alowell-ssl/ethernet_audio/spice/pmos_switch.asc

C1: cap; 10000n
Q1: pnp; 2N3906
R1: res; 10k
R2: res; 10k
R3: res; 100
S1: sw; MYSW
V1: voltage; 12
V2: voltage; PWL(0 -1 1 -1 1.000001 1 2 1)
Named nets: 0
.tran 3
.model MYSW SW()
