alowell-ssl/ethernet_audio/kicad/tdm2ethernet1/tdm2ethernet1.kicad_pcb

## KiCad design kicad/tdm2ethernet1/tdm2ethernet1.kicad_pcb (2025-10-06)

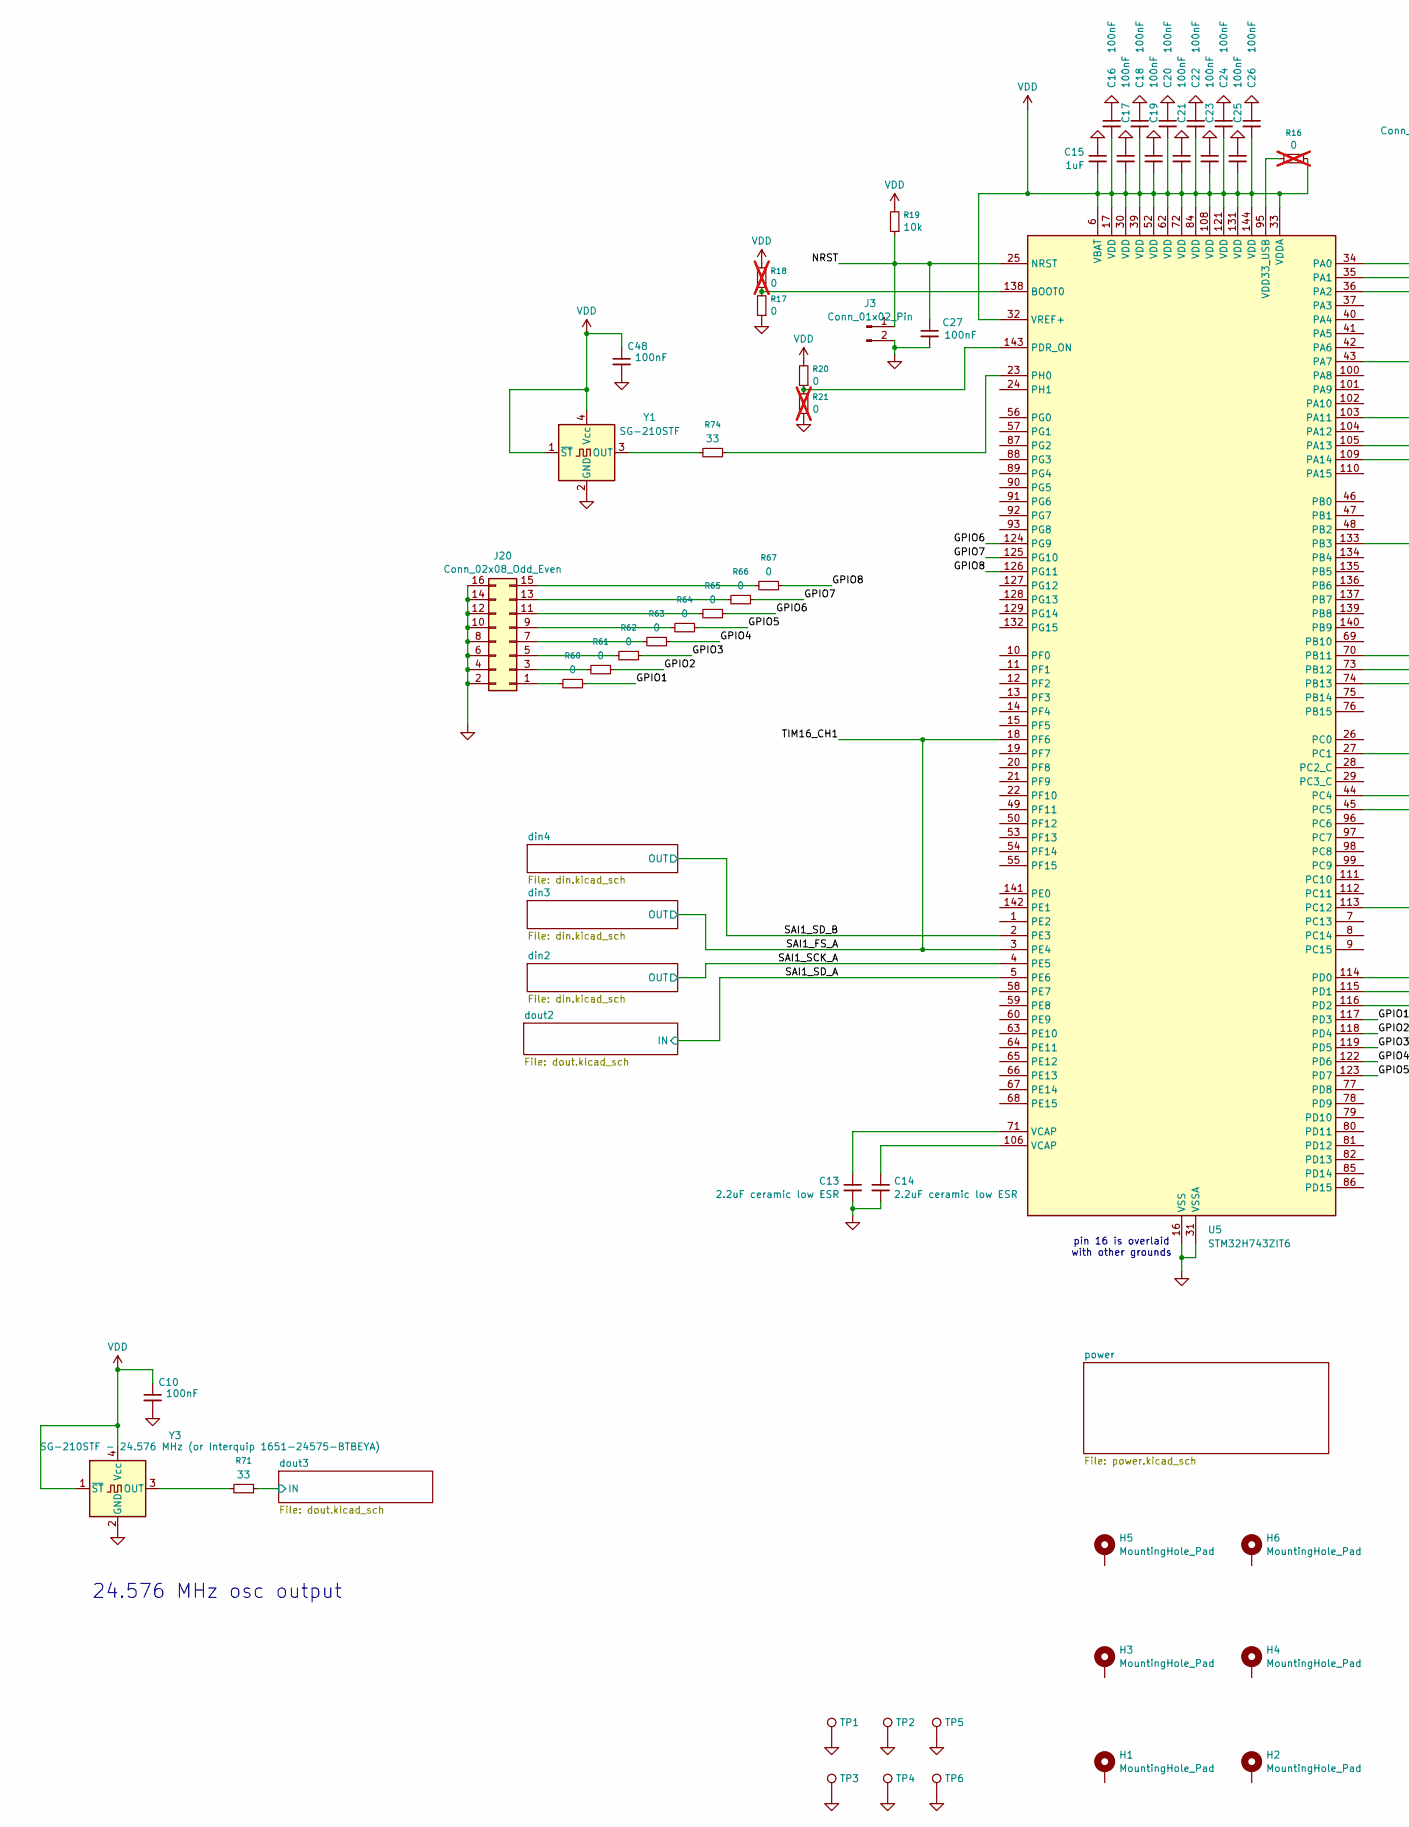
[picture p1: schematic tdm2ethernet1.kicad_sch, part in row 1, column 1]

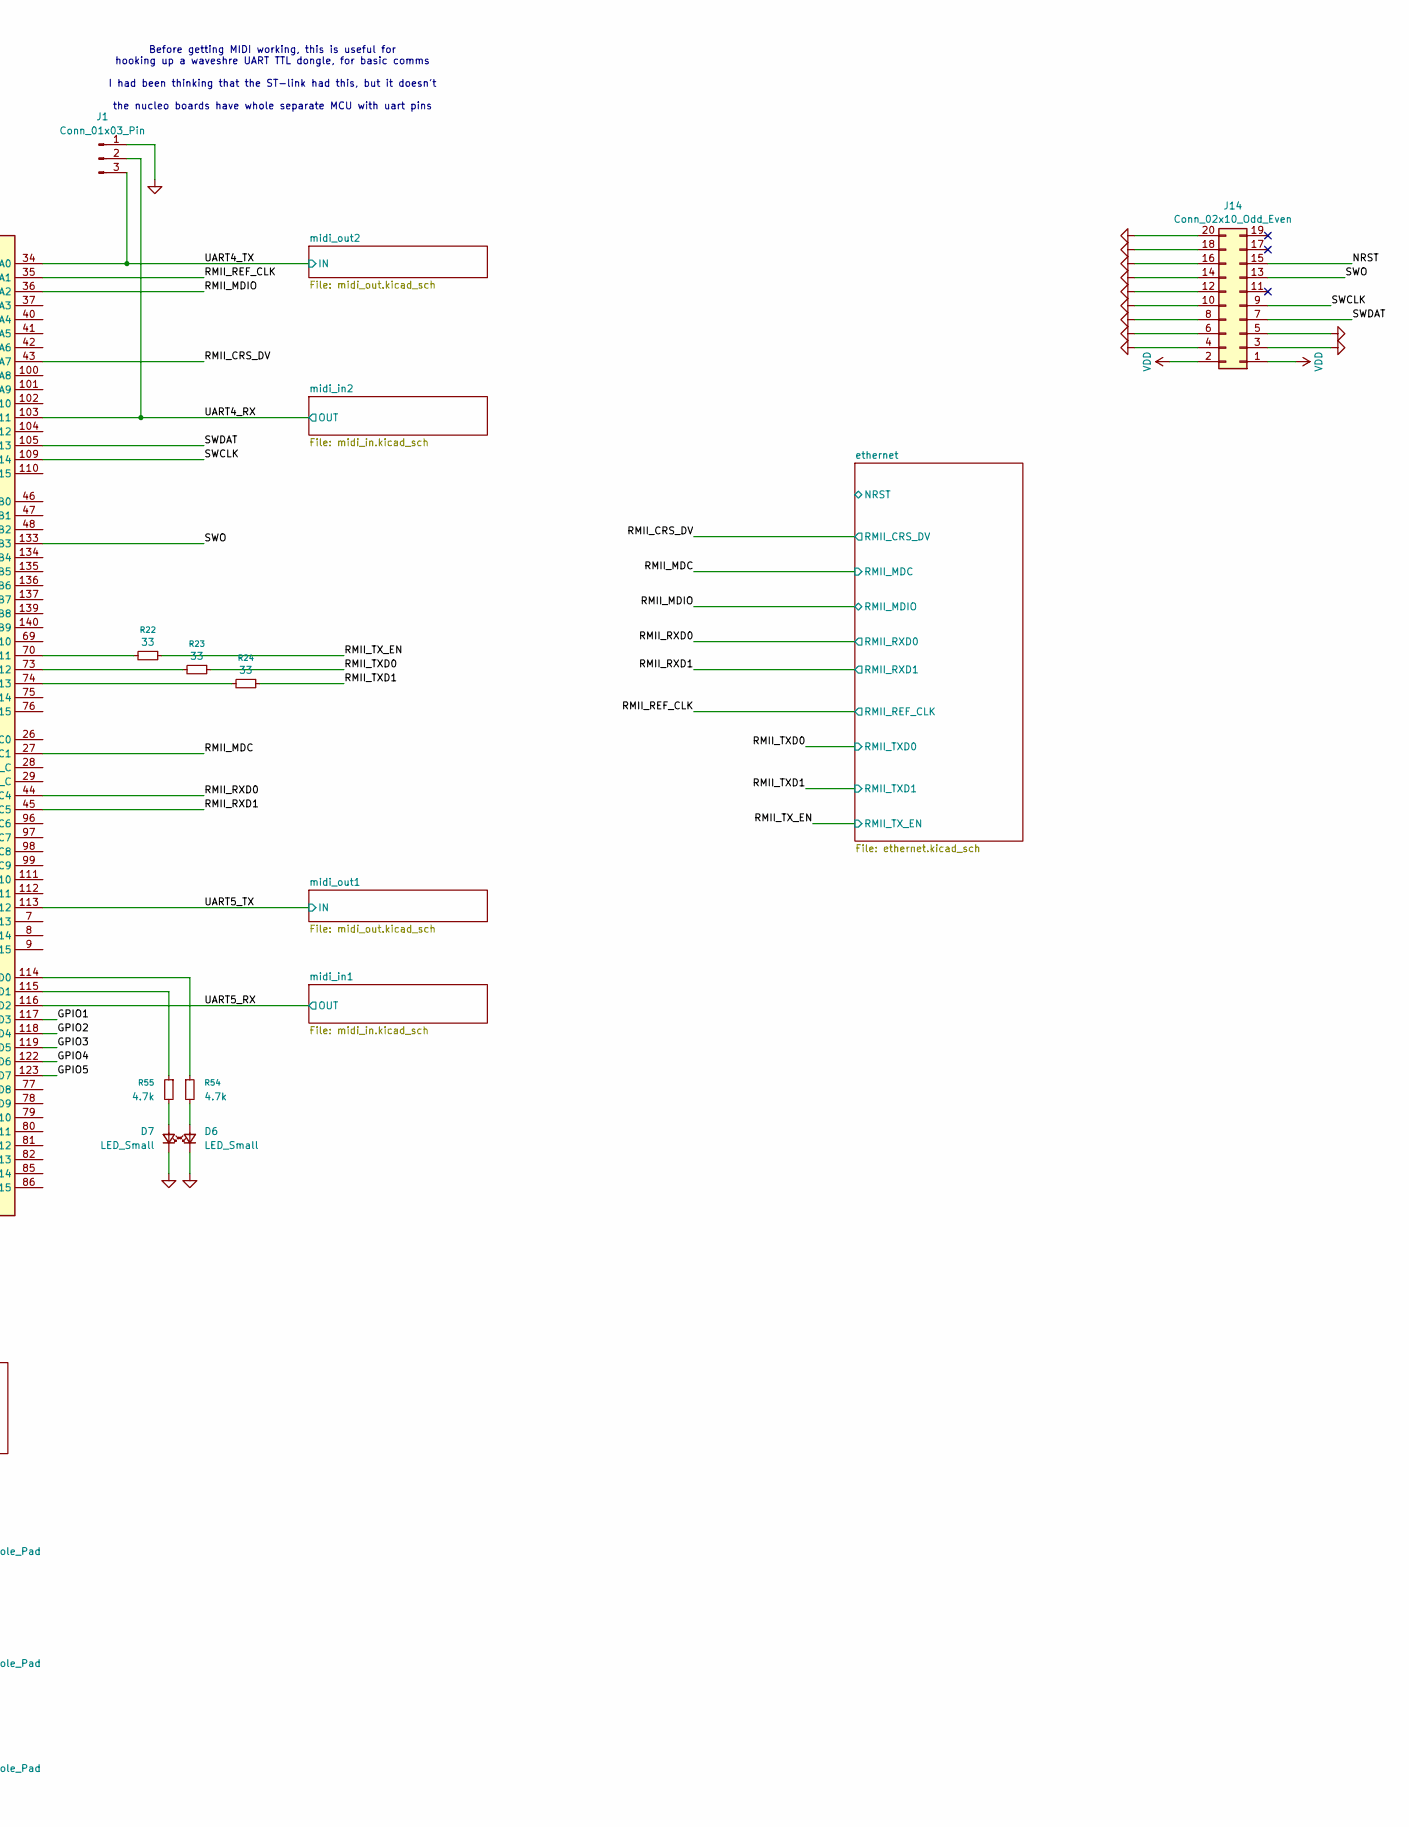
[picture p2: schematic tdm2ethernet1.kicad_sch, part in row 1, column 2]

Parts:
C10, C16, C17, C18, C19, C20, C21, C22, C23, C24, C25, C26, C27, C48: 100nF; C_0603_1608Metric; LCSC Part # C14663
C13, C14: 2.2uF ceramic low ESR; C_0603_1608Metric; LCSC Part # C23630
C15: 1uF; C_0603_1608Metric; LCSC Part # C15849
D6, D7: LED_Small; LED_0603_1608Metric; LCSC Part # C2286
H1, H2, H3, H4, H5, H6: MountingHole_Pad; MountingHole_3.2mm_M3_DIN965
J1: Conn_01x03_Pin; PinHeader_1x03_P2.54mm_Vertical
J3: Conn_01x02_Pin; PinHeader_1x02_P2.54mm_Vertical
J14: Conn_02x10_Odd_Even; PinHeader_2x10_P2.54mm_Vertical
J20: Conn_02x08_Odd_Even; PinSocket_2x08_P2.54mm_Vertical
R16, R18, R21: 0; R_0603_1608Metric; LCSC Part # C21189; not fitted
R17, R20, R60, R61, R62, R63, R64, R65, R66, R67: 0; R_0603_1608Metric; LCSC Part # C21189
R19: 10k; R_0603_1608Metric; LCSC Part # C15401
R22, R23, R24, R71, R74: 33; R_0603_1608Metric; LCSC Part # C23140
R54, R55: 4.7k; R_0603_1608Metric; LCSC Part # C23162
TP1, TP2, TP3, TP4, TP5, TP6: TestPoint; TestPoint_THTPad_D1.5mm_Drill0.7mm
U5: STM32H743ZIT6; LQFP-144_20x20mm_P0.5mm; LCSC Part # C114408
Y1: SG-210STF; Oscillator_SMD_SeikoEpson_SG210-4Pin_2.5x2.0mm; LCSC Part # C70560
Y3: SG-210STF - 24.576 MHz (or Interquip 1651-24575-B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; Oscillator_SMD_SeikoEpson_SG210-4Pin_2.5x2.0mm; LCSC Part # C3003263

Connections:
/GPIO1: R60.1, U5.117 (PD3)
/GPIO2: R61.1, U5.118 (PD4)
/GPIO3: R62.1, U5.119 (PD5)
/GPIO4: R63.1, U5.122 (PD6)
/GPIO5: R64.1, U5.123 (PD7)
/GPIO6: R65.1, U5.124 (PG9)
/GPIO7: R66.1, U5.125 (PG10)
/GPIO8: R67.1, U5.126 (PG11)
/NRST: C27.1, J3.1, J14.15, R19.1, U5.25 (NRST)
/RMII_CRS_DV: U5.43 (PA7); also elsewhere on the board
/RMII_MDC: U5.27 (PC1); also elsewhere on the board
/RMII_MDIO: U5.36 (PA2); also elsewhere on the board
/RMII_REF_CLK: U5.35 (PA1); also elsewhere on the board
/RMII_RXD0: U5.44 (PC4); also elsewhere on the board
/RMII_RXD1: U5.45 (PC5); also elsewhere on the board
/RMII_TXD0: R23.1; also elsewhere on the board
/RMII_TXD1: R24.1; also elsewhere on the board
/RMII_TX_EN: R22.1; also elsewhere on the board
/SAI1_FS_A: U5.3 (PE4), U5.18 (PF6); also elsewhere on the board
/SAI1_SCK_A: U5.4 (PE5); also elsewhere on the board
/SAI1_SD_A: U5.5 (PE6); also elsewhere on the board
/SAI1_SD_B: U5.2 (PE3); also elsewhere on the board
/SWCLK: J14.9, U5.109 (PA14)
/SWDAT: J14.7, U5.105 (PA13)
/SWO: J14.13, U5.133 (PB3)
/UART4_RX: J1.2, U5.103 (PA11); also elsewhere on the board
/UART4_TX: J1.3, U5.34 (PA0); also elsewhere on the board
/UART5_RX: U5.116 (PD2); also elsewhere on the board
/UART5_TX: U5.113 (PC12); also elsewhere on the board
/dout3/IN: R71.1; also elsewhere on the board
GND: C10.2, C13.2, C14.2, C15.1, C16.1, C17.1, C18.1, C19.1, C20.1, C21.1, C22.1, C23.1, C24.1, C25.1, C26.1, C27.2, C48.2, D6.1 (K), D7.1 (K), J1.1, J3.2, J14.3, J14.4, J14.5, J14.6, J14.8, J14.10, J14.12, J14.14, J14.16, J14.18, J14.20, J20.2, J20.4, J20.6, J20.8, J20.10, J20.12, J20.14, J20.16, R17.1, R21.1, TP1.1, TP2.1, TP3.1, TP4.1, TP5.1, TP6.1, U5.16 (VSS), U5.31 (VSSA), U5.38 (VSS), U5.51 (VSS), U5.61 (VSS), U5.83 (VSS), U5.94 (VSS), U5.107 (VSS), U5.120 (VSS), U5.130 (VSS), Y1.2 (GND), Y3.2 (GND); also elsewhere on the board
unnamed: C13.1, U5.71 (VCAP)
unnamed: C14.1, U5.106 (VCAP)
unnamed: D6.2 (A), R54.2
unnamed: D7.2 (A), R55.2
unnamed: J20.1, R60.2
unnamed: J20.3, R61.2
unnamed: J20.5, R62.2
unnamed: J20.7, R63.2
unnamed: J20.9, R64.2
unnamed: J20.11, R65.2
unnamed: J20.13, R66.2
unnamed: J20.15, R67.2
unnamed: R17.2, R18.1, U5.138 (BOOT0)
unnamed: R22.2, U5.70 (PB11)
unnamed: R23.2, U5.73 (PB12)
unnamed: R24.2, U5.74 (PB13)
unnamed: R54.1, U5.114 (PD0)
unnamed: R55.1, U5.115 (PD1)
unnamed: R20.1, R21.2, U5.143 (PDR_ON)
unnamed: R74.1, U5.23 (PH0)
unnamed: R16.1, U5.95 (VDD33_USB)
unnamed: R74.2, Y1.3 (OUT)
unnamed: R71.2, Y3.3 (OUT)
VDD: C10.1, C15.2, C16.2, C17.2, C18.2, C19.2, C20.2, C21.2, C22.2, C23.2, C24.2, C25.2, C26.2, C48.1, J14.1, J14.2, R16.2, R18.2, R19.2, R20.2, U5.6 (VBAT), U5.17 (VDD), U5.30 (VDD), U5.32 (VREF+), U5.33 (VDDA), U5.39 (VDD), U5.52 (VDD), U5.62 (VDD), U5.72 (VDD), U5.84 (VDD), U5.108 (VDD), U5.121 (VDD), U5.131 (VDD), U5.144 (VDD), Y1.1 (~ST), Y1.4 (Vcc), Y3.1 (~ST), Y3.4 (Vcc); also elsewhere on the board

Notes on the sheet:
24.576 MHz osc output
pin 16 is overlaid with other grounds
Before getting MIDI working, this is useful for hooking up a waveshre UART TTL dongle, for basic comms I had been thinking that the ST-link had this, but it doesn't the nucleo boards have whole separate MCU with uart pins

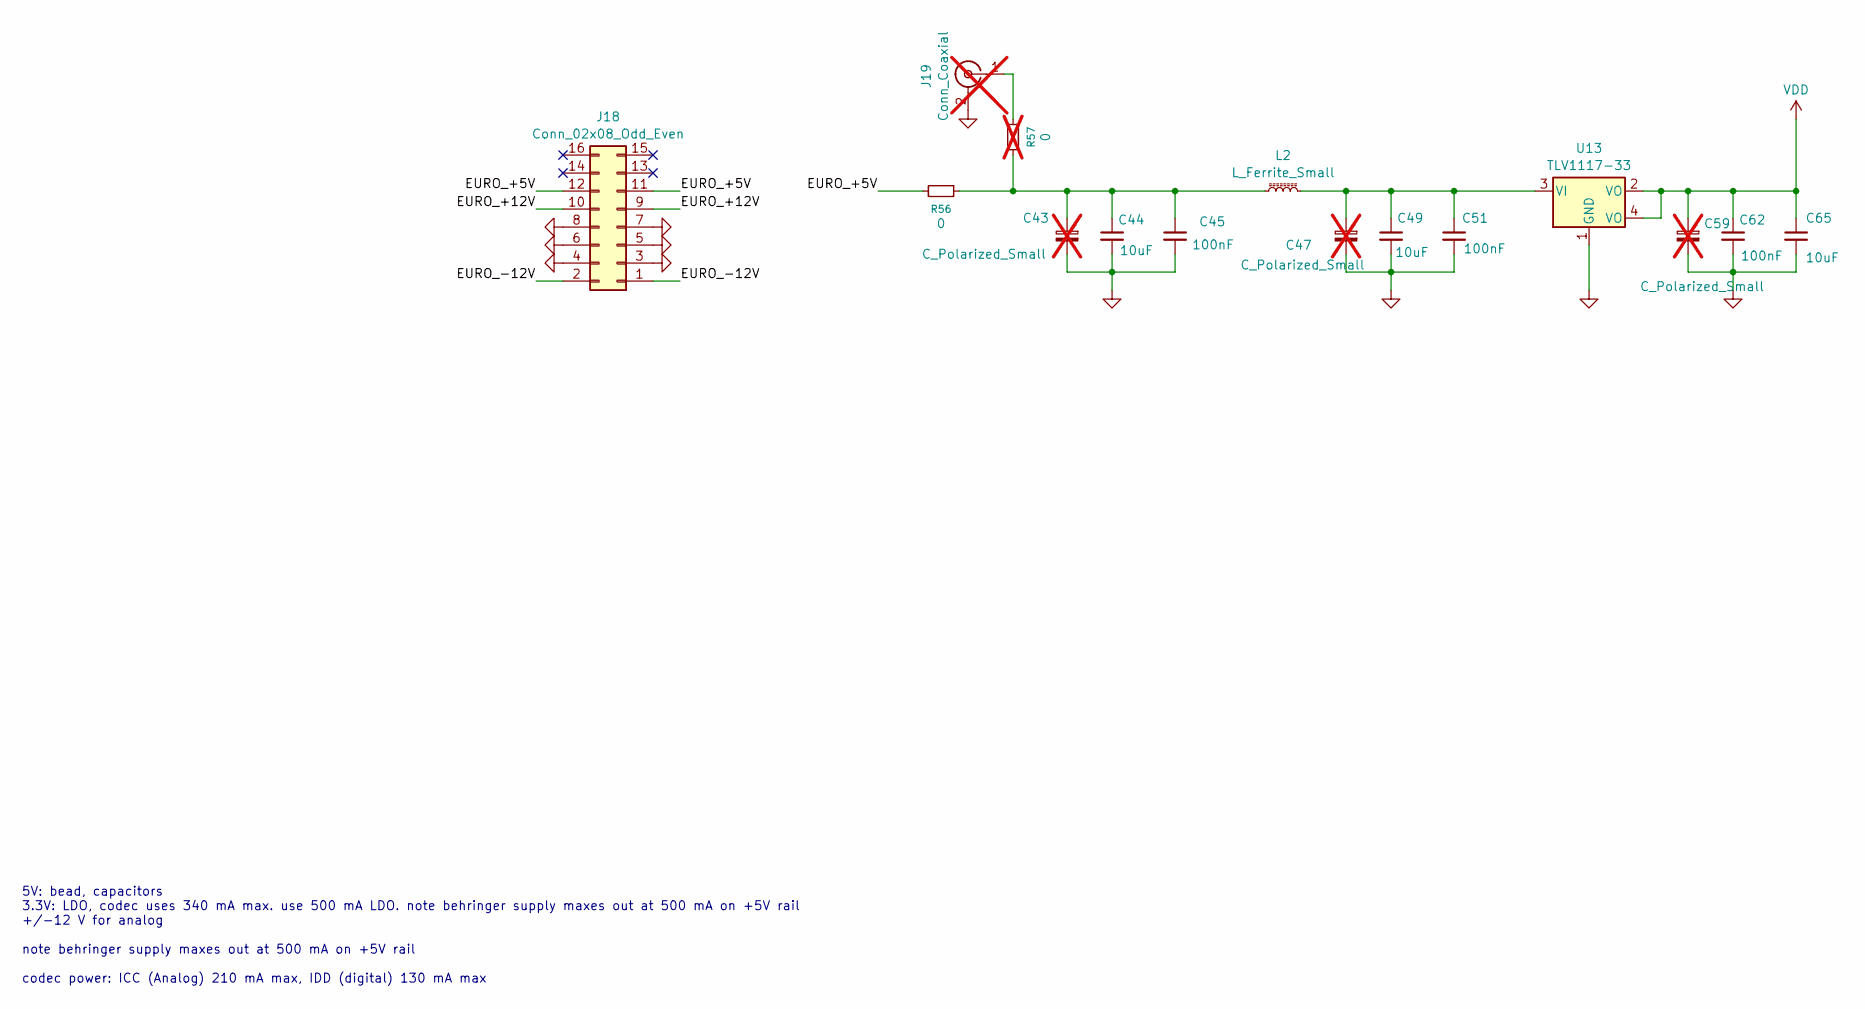
[picture p3: schematic power.kicad_sch]

Parts:
C43, C47, C59: C_Polarized_Small; CP_Radial_D8.0mm_P3.50mm; not fitted
C44, C49, C65: 10uF; C_0603_1608Metric; LCSC Part # C96446
C45, C51, C62: 100nF; C_0603_1608Metric; LCSC Part # C14663
J18: Conn_02x08_Odd_Even; PinSocket_2x08_P2.54mm_Vertical
J19: Conn_Coaxial; SMA_Amphenol_901-144_Vertical; not fitted
L2: L_Ferrite_Small; L_0603_1608Metric; LCSC Part # C1002
R56: 0; R_0603_1608Metric; LCSC Part # C21189
R57: 0; R_0603_1608Metric; LCSC Part # C21189; not fitted
U13: TLV1117-33; SOT-223

Connections:
/power/EURO_+5V: J18.11, J18.12, R56.1
/power/EURO_+12V: J18.9, J18.10
/power/EURO_-12V: J18.1, J18.2
GND: C43.2, C44.2, C45.2, C47.2, C49.2, C51.2, C59.2, C62.2, C65.2, J18.3, J18.4, J18.5, J18.6, J18.7, J18.8, J19.2 (Ext), U13.1 (GND); also elsewhere on the board
unnamed: C43.1, C44.1, C45.1, L2.1, R56.2, R57.1
unnamed: J19.1 (In), R57.2
unnamed: C47.1, C49.1, C51.1, L2.2, U13.3 (VI)
VDD: C59.1, C62.1, C65.1, U13.2 (VO), U13.4 (VO); also elsewhere on the board

Notes on the sheet:
5V: bead, capacitors 3.3V: LDO, codec uses 340 mA max. use 500 mA LDO. note behringer supply maxes out at 500 mA on +5V rail +/-12 V for analog note behringer supply maxes out at 500 mA on +5V rail codec power: ICC (Analog) 210 mA max, IDD (digital) 130 mA max

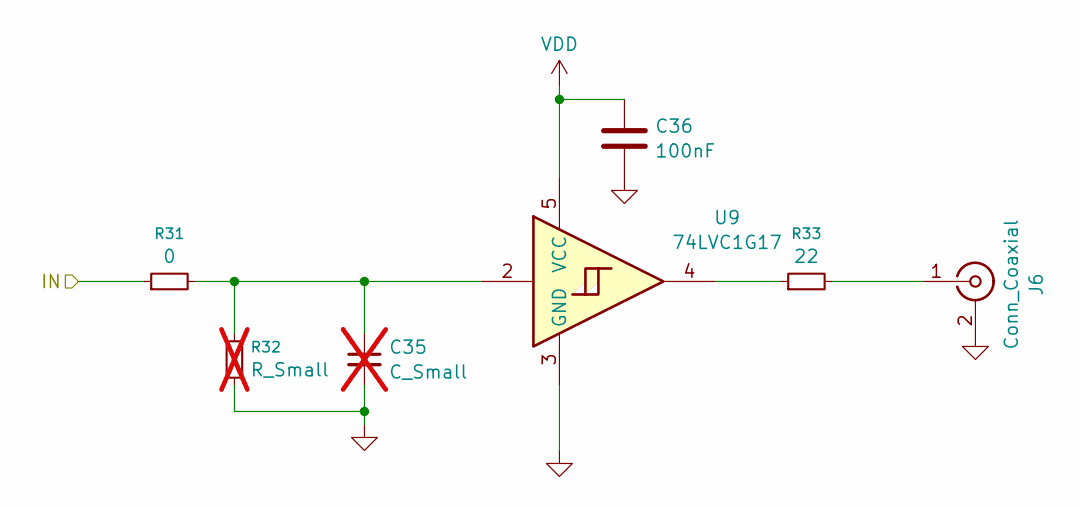
[picture p4: schematic dout.kicad_sch]

Parts:
C35: C_Small; C_0603_1608Metric; not fitted
C36: 100nF; C_0603_1608Metric; LCSC Part # C14663
J6: Conn_Coaxial; SMA_Amphenol_901-144_Vertical
R31: 0; R_0603_1608Metric; LCSC Part # C21189
R32: R_Small; R_0603_1608Metric; not fitted
R33: 22; R_0603_1608Metric; LCSC Part # C23345
U9: 74LVC1G17; SOT-23-5; LCSC Part # C7836

Connections:
/SAI1_SD_A: R31.1; also elsewhere on the board
GND: C35.2, C36.2, J6.2 (Ext), R32.1, U9.3 (GND); also elsewhere on the board
unnamed: C35.1, R31.2, R32.2, U9.2
unnamed: J6.1 (In), R33.2
unnamed: R33.1, U9.4
VDD: C36.1, U9.5 (VCC); also elsewhere on the board

Parts of its further copies:
C12: C_Small; C_0603_1608Metric; not fitted
C52: 100nF; C_0603_1608Metric; LCSC Part # C14663
J2: Conn_Coaxial; SMA_Amphenol_901-144_Vertical
R72: 0; R_0603_1608Metric; LCSC Part # C21189
R73: R_Small; R_0603_1608Metric; not fitted
R76: 22; R_0603_1608Metric; LCSC Part # C23345
U14: 74LVC1G17; SOT-23-5; LCSC Part # C7836

Connections of its further copies:
/dout3/IN: R72.1; also elsewhere on the board
GND: C12.2, C52.2, J2.2 (Ext), R73.1, U14.3 (GND); also elsewhere on the board
unnamed: C12.1, R72.2, R73.2, U14.2
unnamed: J2.1 (In), R76.2
unnamed: R76.1, U14.4
VDD: C52.1, U14.5 (VCC); also elsewhere on the board

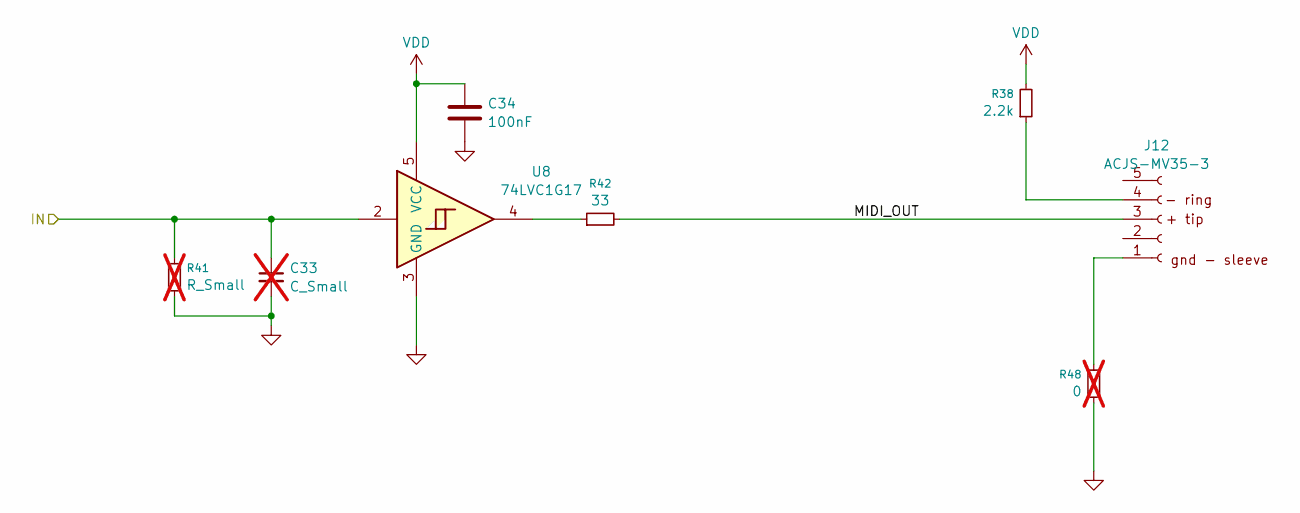
[picture p5: schematic midi_out.kicad_sch]

Parts:
C33: C_Small; C_0603_1608Metric; not fitted
C34: 100nF; C_0603_1608Metric; LCSC Part # C14663
J12: ACJS-MV35-3; Amphenol_ACJS
R38: 2.2k; R_0603_1608Metric; LCSC Part # C4190
R41: R_Small; R_0603_1608Metric; not fitted
R42: 33; R_0603_1608Metric; LCSC Part # C23140
R48: 0; R_0603_1608Metric; LCSC Part # C21189; not fitted
U8: 74LVC1G17; SOT-23-5; LCSC Part # C7836

Connections:
/UART5_TX: C33.1, R41.2, U8.2; also elsewhere on the board
/midi_out1/MIDI_OUT: J12.3, R42.2
GND: C33.2, C34.2, R41.1, R48.1, U8.3 (GND); also elsewhere on the board
unnamed: J12.1, R48.2
unnamed: J12.4, R38.1
unnamed: R42.1, U8.4
VDD: C34.1, R38.2, U8.5 (VCC); also elsewhere on the board

Parts of its further copies:
C29: C_Small; C_0603_1608Metric; not fitted
C30: 100nF; C_0603_1608Metric; LCSC Part # C14663
J13: ACJS-MV35-3; Amphenol_ACJS
R28: R_Small; R_0603_1608Metric; not fitted
R29: 33; R_0603_1608Metric; LCSC Part # C23140
R30: 2.2k; R_0603_1608Metric; LCSC Part # C4190
R49: 0; R_0603_1608Metric; LCSC Part # C21189; not fitted
U6: 74LVC1G17; SOT-23-5; LCSC Part # C7836

Connections of its further copies:
/UART4_TX: C29.1, R28.2, U6.2; also elsewhere on the board
/midi_out2/MIDI_OUT: J13.3, R29.2
GND: C29.2, C30.2, R28.1, R49.1, U6.3 (GND); also elsewhere on the board
unnamed: J13.1, R49.2
unnamed: J13.4, R30.1
unnamed: R29.1, U6.4
VDD: C30.1, R30.2, U6.5 (VCC); also elsewhere on the board

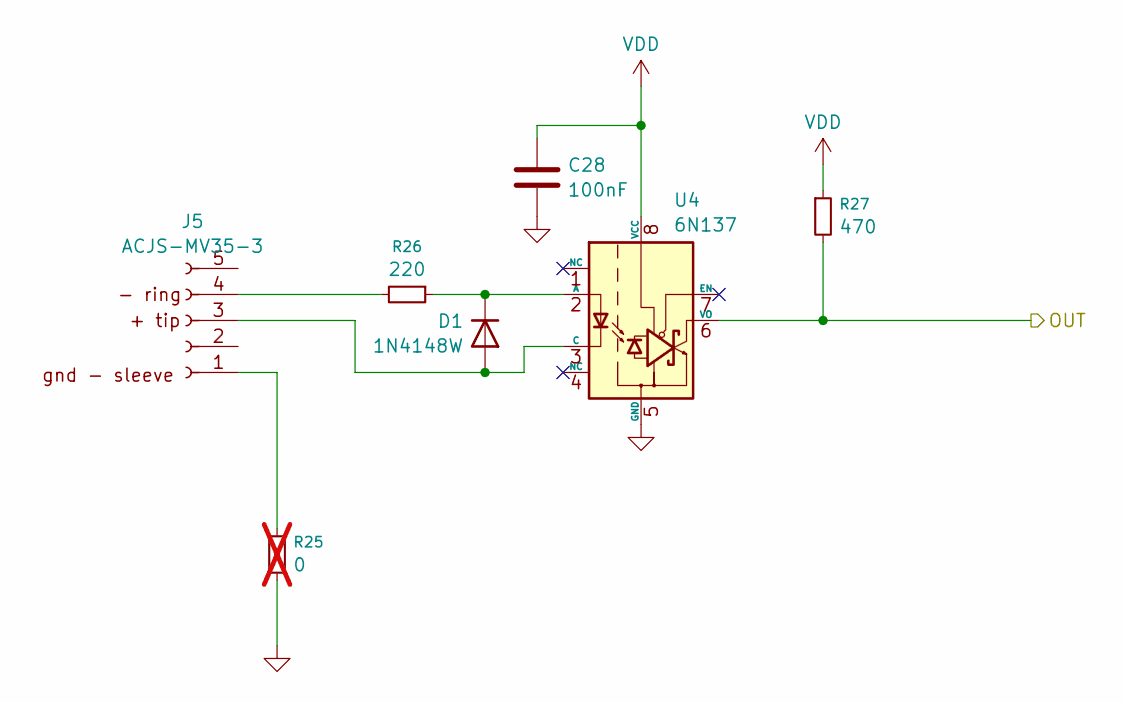
[picture p6: schematic midi_in.kicad_sch]

Parts:
C28: 100nF; C_0603_1608Metric; LCSC Part # C14663
D1: 1N4148W; D_SOD-123; LCSC Part # C81598
J5: ACJS-MV35-3; Amphenol_ACJS
R25: 0; R_0603_1608Metric; LCSC Part # C21189; not fitted
R26: 220; R_0603_1608Metric; LCSC Part # C22962
R27: 470; R_0603_1608Metric; LCSC Part # C23179
U4: 6N137; DIP-8_W7.62mm

Connections:
/UART4_RX: R27.2, U4.6 (VO); also elsewhere on the board
GND: C28.2, R25.1, U4.5 (GND); also elsewhere on the board
unnamed: D1.2 (A), J5.3, U4.3 (C)
unnamed: D1.1 (K), R26.1, U4.2 (A)
unnamed: J5.1, R25.2
unnamed: J5.4, R26.2
VDD: C28.1, R27.1, U4.8 (VCC); also elsewhere on the board

Parts of its further copies:
C32: 100nF; C_0603_1608Metric; LCSC Part # C14663
D5: 1N4148W; D_SOD-123; LCSC Part # C81598
J10: ACJS-MV35-3; Amphenol_ACJS
R44: 220; R_0603_1608Metric; LCSC Part # C22962
R45: 470; R_0603_1608Metric; LCSC Part # C23179
R50: 0; R_0603_1608Metric; LCSC Part # C21189; not fitted
U7: 6N137; DIP-8_W7.62mm

Connections of its further copies:
/UART5_RX: R45.2, U7.6 (VO); also elsewhere on the board
GND: C32.2, R50.1, U7.5 (GND); also elsewhere on the board
unnamed: D5.2 (A), J10.3, U7.3 (C)
unnamed: D5.1 (K), R44.1, U7.2 (A)
unnamed: J10.1, R50.2
unnamed: J10.4, R44.2
VDD: C32.1, R45.1, U7.8 (VCC); also elsewhere on the board

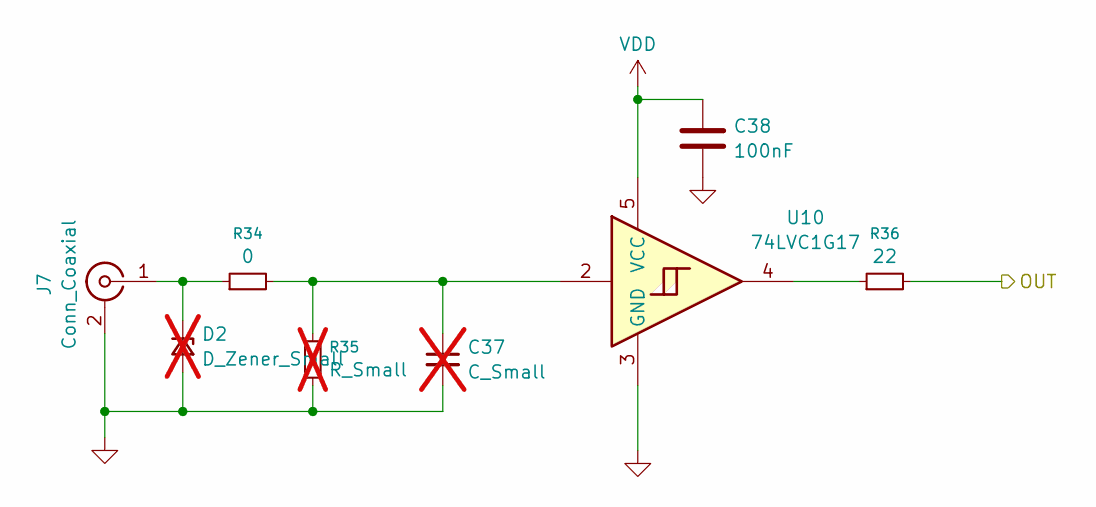
[picture p7: schematic din.kicad_sch]

Parts:
C37: C_Small; C_0603_1608Metric; not fitted
C38: 100nF; C_0603_1608Metric; LCSC Part # C14663
D2: D_Zener_Small; D_SOD-123F; not fitted
J7: Conn_Coaxial; SMA_Amphenol_901-144_Vertical
R34: 0; R_0603_1608Metric; LCSC Part # C21189
R35: R_Small; R_0603_1608Metric; not fitted
R36: 22; R_0603_1608Metric; LCSC Part # C23345
U10: 74LVC1G17; SOT-23-5; LCSC Part # C7836

Connections:
/SAI1_SCK_A: R36.2; also elsewhere on the board
GND: C37.2, C38.2, D2.2 (A), J7.2 (Ext), R35.1, U10.3 (GND); also elsewhere on the board
unnamed: C37.1, R34.2, R35.2, U10.2
unnamed: D2.1 (K), J7.1 (In), R34.1
unnamed: R36.1, U10.4
VDD: C38.1, U10.5 (VCC); also elsewhere on the board

Parts of its further copies:
C39, C41: C_Small; C_0603_1608Metric; not fitted
C40, C42: 100nF; C_0603_1608Metric; LCSC Part # C14663
D3, D4: D_Zener_Small; D_SOD-123F; not fitted
J8, J11: Conn_Coaxial; SMA_Amphenol_901-144_Vertical
R37, R43: 0; R_0603_1608Metric; LCSC Part # C21189
R39, R46: R_Small; R_0603_1608Metric; not fitted
R40, R47: 22; R_0603_1608Metric; LCSC Part # C23345
U11, U12: 74LVC1G17; SOT-23-5; LCSC Part # C7836

Connections of its further copies:
/SAI1_FS_A: R40.2; also elsewhere on the board
/SAI1_SD_B: R47.2; also elsewhere on the board
GND: C39.2, C40.2, C41.2, C42.2, D3.2 (A), D4.2 (A), J8.2 (Ext), J11.2 (Ext), R39.1, R46.1, U11.3 (GND), U12.3 (GND); also elsewhere on the board
unnamed: C39.1, R37.2, R39.2, U11.2
unnamed: C41.1, R43.2, R46.2, U12.2
unnamed: D3.1 (K), J8.1 (In), R37.1
unnamed: D4.1 (K), J11.1 (In), R43.1
unnamed: R40.1, U11.4
unnamed: R47.1, U12.4
VDD: C40.1, C42.1, U11.5 (VCC), U12.5 (VCC); also elsewhere on the board

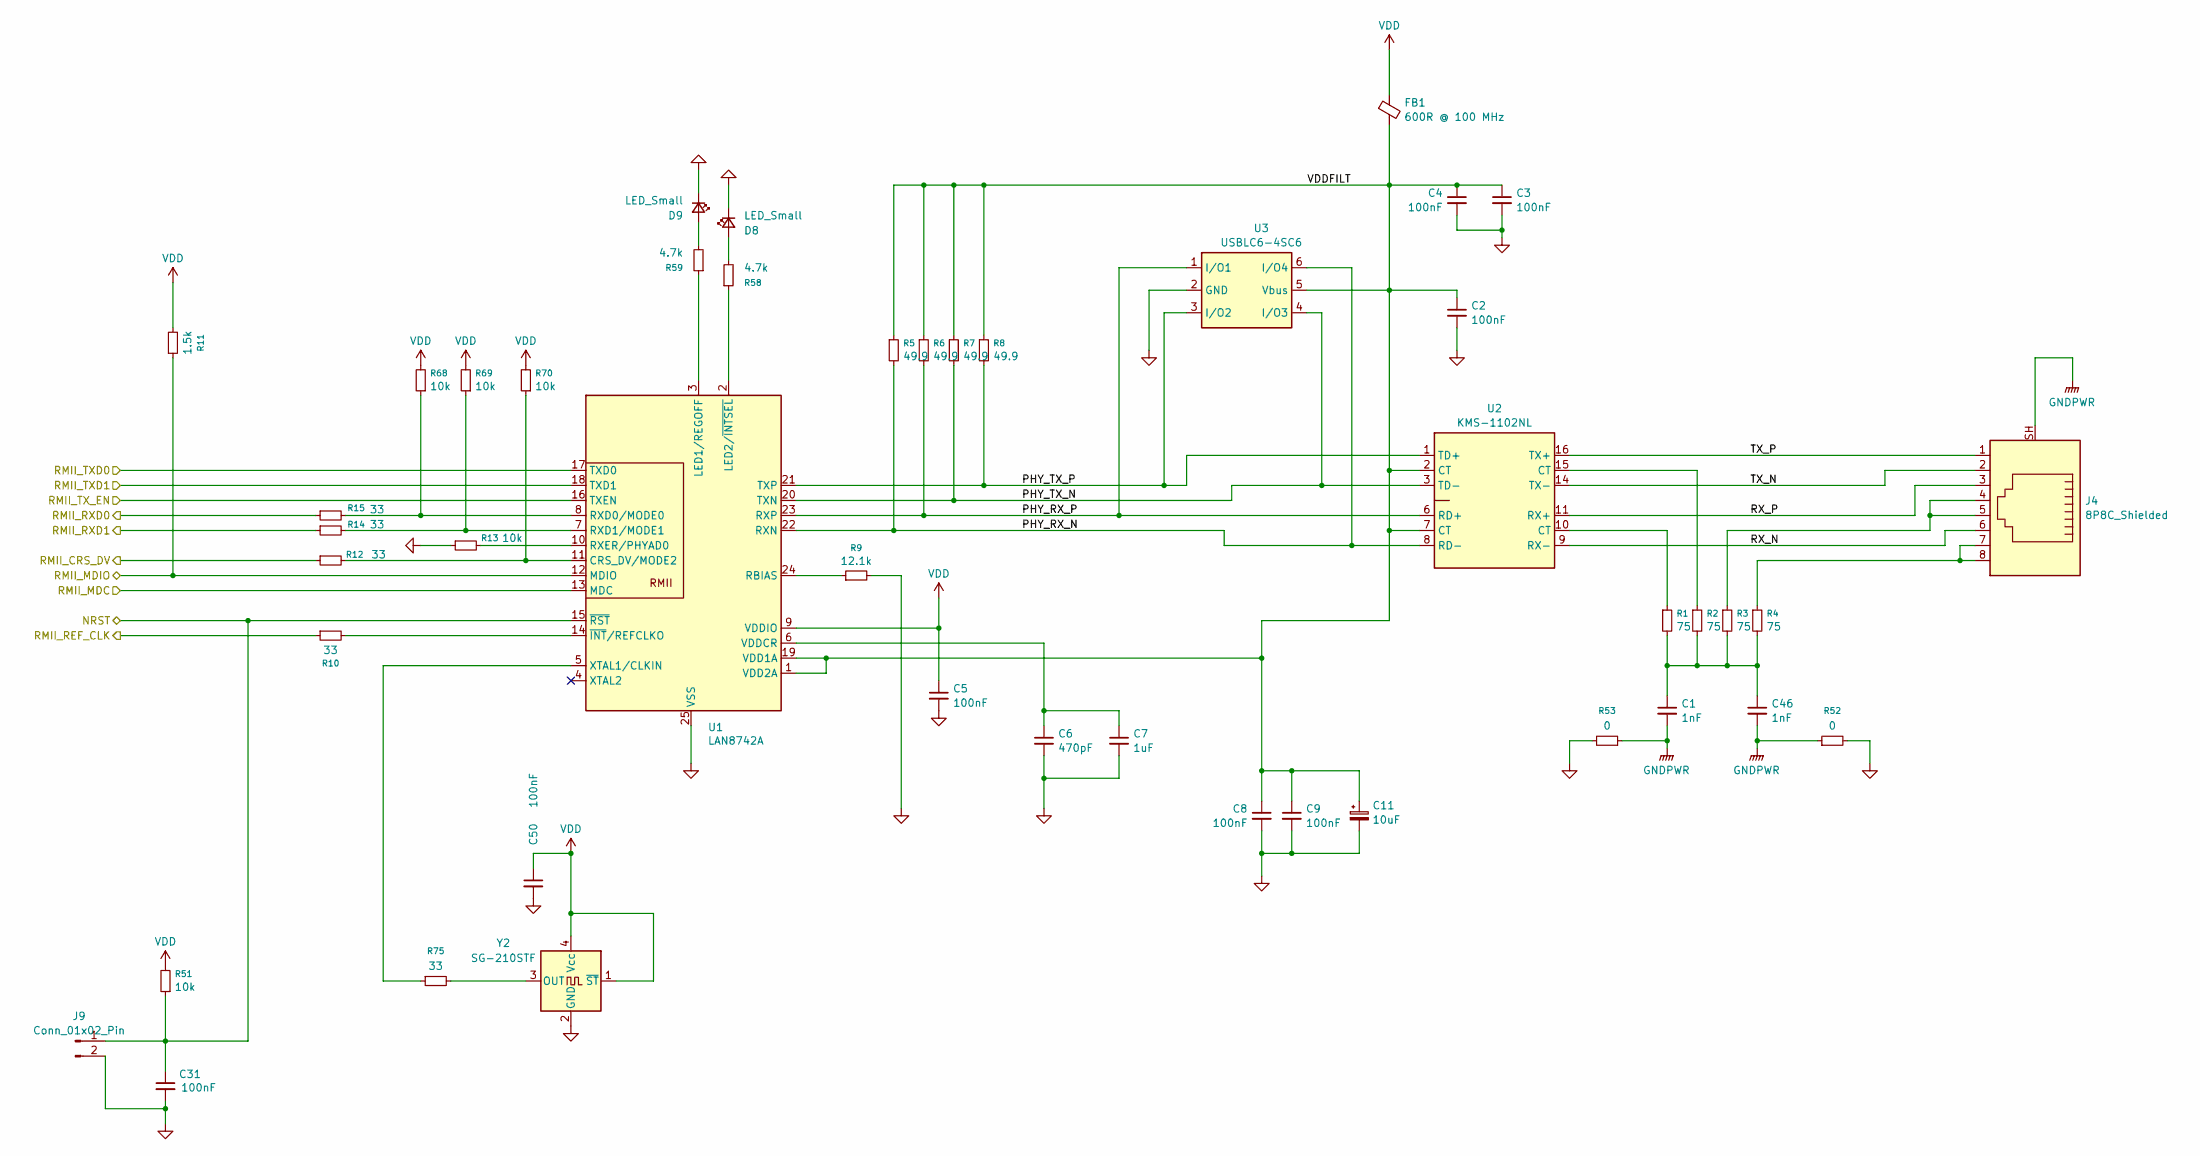
[picture p8: schematic ethernet.kicad_sch]

Parts:
C1, C46: 1nF; C_0603_1608Metric; LCSC Part # C1588
C2, C3, C4, C5, C8, C9, C31, C50: 100nF; C_0603_1608Metric; LCSC Part # C14663
C6: 470pF; C_0603_1608Metric; LCSC Part # C1620
C7: 1uF; C_0603_1608Metric; LCSC Part # C15849
C11: 10uF; C_1206_3216Metric; LCSC Part # C13585
D8, D9: LED_Small; LED_0603_1608Metric; LCSC Part # C2286
FB1: 600R @ 100 MHz; L_0603_1608Metric; LCSC Part # C1002
J4: 8P8C_Shielded; A-2014-2S-4-N-R
J9: Conn_01x02_Pin; PinHeader_1x02_P2.54mm_Vertical
R1, R2, R3, R4: 75; R_0603_1608Metric; LCSC Part # C4275
R5, R6, R7, R8: 49.9; R_0603_1608Metric; LCSC Part # C23185
R9: 12.1k; R_0603_1608Metric
R10, R12, R14, R15, R75: 33; R_0603_1608Metric; LCSC Part # C23140
R11: 1.5k; R_0603_1608Metric; LCSC Part # C22843
R13, R51, R68, R69, R70: 10k; R_0603_1608Metric; LCSC Part # C15401
R52, R53: 0; R_0603_1608Metric; LCSC Part # C21189
R58, R59: 4.7k; R_0603_1608Metric; LCSC Part # C23162
U1: LAN8742A; VQFN-24-1EP_4x4mm_P0.5mm_EP2.5x2.5mm_ThermalVias; LCSC Part # C621424
U2: KMS-1102NL; Untitled
U3: USBLC6-4SC6; SOT-23-6
Y2: SG-210STF; Oscillator_SMD_SeikoEpson_SG210-4Pin_2.5x2.0mm; LCSC Part # C70560

Connections:
/RMII_CRS_DV: R12.1; also elsewhere on the board
/RMII_MDC: U1.13 (MDC); also elsewhere on the board
/RMII_MDIO: R11.1, U1.12 (MDIO); also elsewhere on the board
/RMII_REF_CLK: R10.1; also elsewhere on the board
/RMII_RXD0: R15.1; also elsewhere on the board
/RMII_RXD1: R14.1; also elsewhere on the board
/RMII_TXD0: U1.17 (TXD0); also elsewhere on the board
/RMII_TXD1: U1.18 (TXD1); also elsewhere on the board
/RMII_TX_EN: U1.16 (TXEN); also elsewhere on the board
/ethernet/NRST: C31.1, J9.1, R51.1, U1.15 (~RST)
/ethernet/PHY_RX_N: R5.2, U1.22 (RXN), U2.8 (RD-), U3.6 (I/O4)
/ethernet/PHY_RX_P: R6.2, U1.23 (RXP), U2.6 (RD+), U3.1 (I/O1)
/ethernet/PHY_TX_N: R7.2, U1.20 (TXN), U2.3 (TD-), U3.4 (I/O3)
/ethernet/PHY_TX_P: R8.2, U1.21 (TXP), U2.1 (TD+), U3.3 (I/O2)
/ethernet/RX_N: J4.6, U2.9 (RX-)
/ethernet/RX_P: J4.3, U2.11 (RX+)
/ethernet/TX_N: J4.2, U2.14 (TX-)
/ethernet/TX_P: J4.1, U2.16 (TX+)
/ethernet/VDDFILT: C2.1, C3.1, C4.1, C8.1, C9.1, C11.1, FB1.2, R5.1, R6.1, R7.1, R8.1, U1.1 (VDD2A), U1.19 (VDD1A), U2.2 (CT), U2.7 (CT), U3.5 (Vbus)
GND: C2.2, C3.2, C4.2, C5.2, C6.2, C7.2, C8.2, C9.2, C11.2, C31.2, C50.2, D8.1 (K), D9.1 (K), J9.2, R9.2, R13.1, R52.2, R53.2, U1.25 (VSS), U3.2 (GND), Y2.2 (GND); also elsewhere on the board
GNDPWR: C1.2, C46.2, J4.SH, R52.1, R53.1
unnamed: C1.1, C46.1, R1.2, R2.2, R3.2, R4.2
unnamed: D8.2 (A), R58.2
unnamed: D9.2 (A), R59.2
unnamed: J4.4, J4.5, R3.1
unnamed: J4.7, J4.8, R4.1
unnamed: R1.1, U2.10 (CT)
unnamed: R2.1, U2.15 (CT)
unnamed: R12.2, R70.1, U1.11 (CRS_DV/MODE2)
unnamed: R59.1, U1.3 (LED1/REGOFF)
unnamed: R58.1, U1.2 (LED2/~INTSEL)
unnamed: R9.1, U1.24 (RBIAS)
unnamed: R15.2, R68.1, U1.8 (RXD0/MODE0)
unnamed: R14.2, R69.1, U1.7 (RXD1/MODE1)
unnamed: R13.2, U1.10 (RXER/PHYAD0)
unnamed: C6.1, C7.1, U1.6 (VDDCR)
unnamed: R75.1, U1.5 (XTAL1/CLKIN)
unnamed: R10.2, U1.14 (~INT/REFCLKO)
unnamed: R75.2, Y2.3 (OUT)
VDD: C5.1, C50.1, FB1.1, R11.2, R51.2, R68.2, R69.2, R70.2, U1.9 (VDDIO), Y2.1 (~ST), Y2.4 (Vcc); also elsewhere on the board
