alowell-ssl/ethernet_audio/kicad/tdm2ethernet1/tdm2ethernet1.kicad_pcb

## KiCad design kicad/tdm2ethernet1/tdm2ethernet1.kicad_pcb (continued)

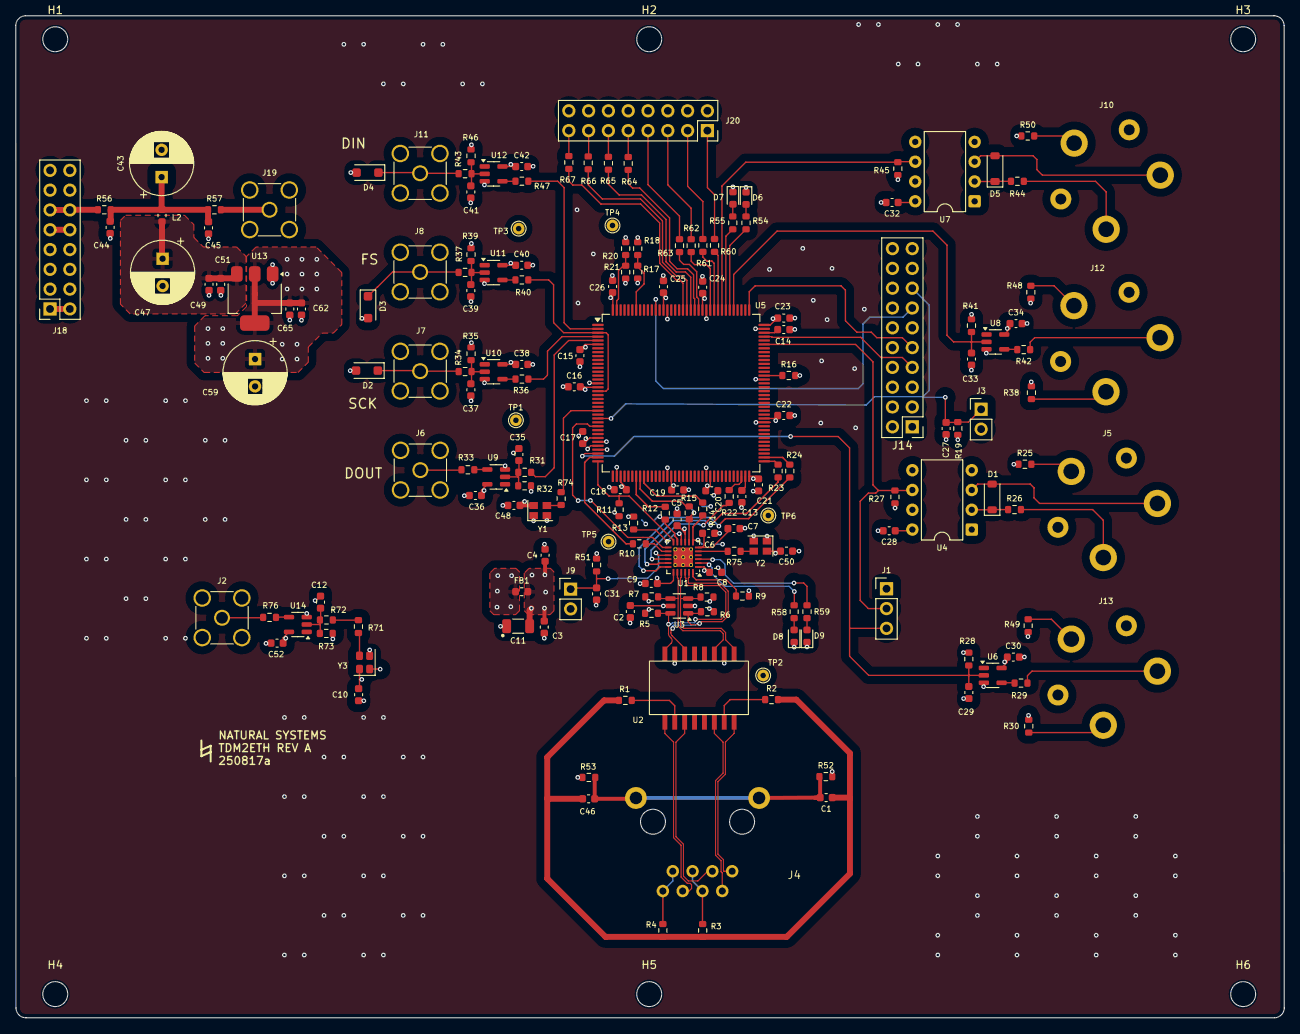
[picture p9: board tdm2ethernet1.kicad_pcb from above]

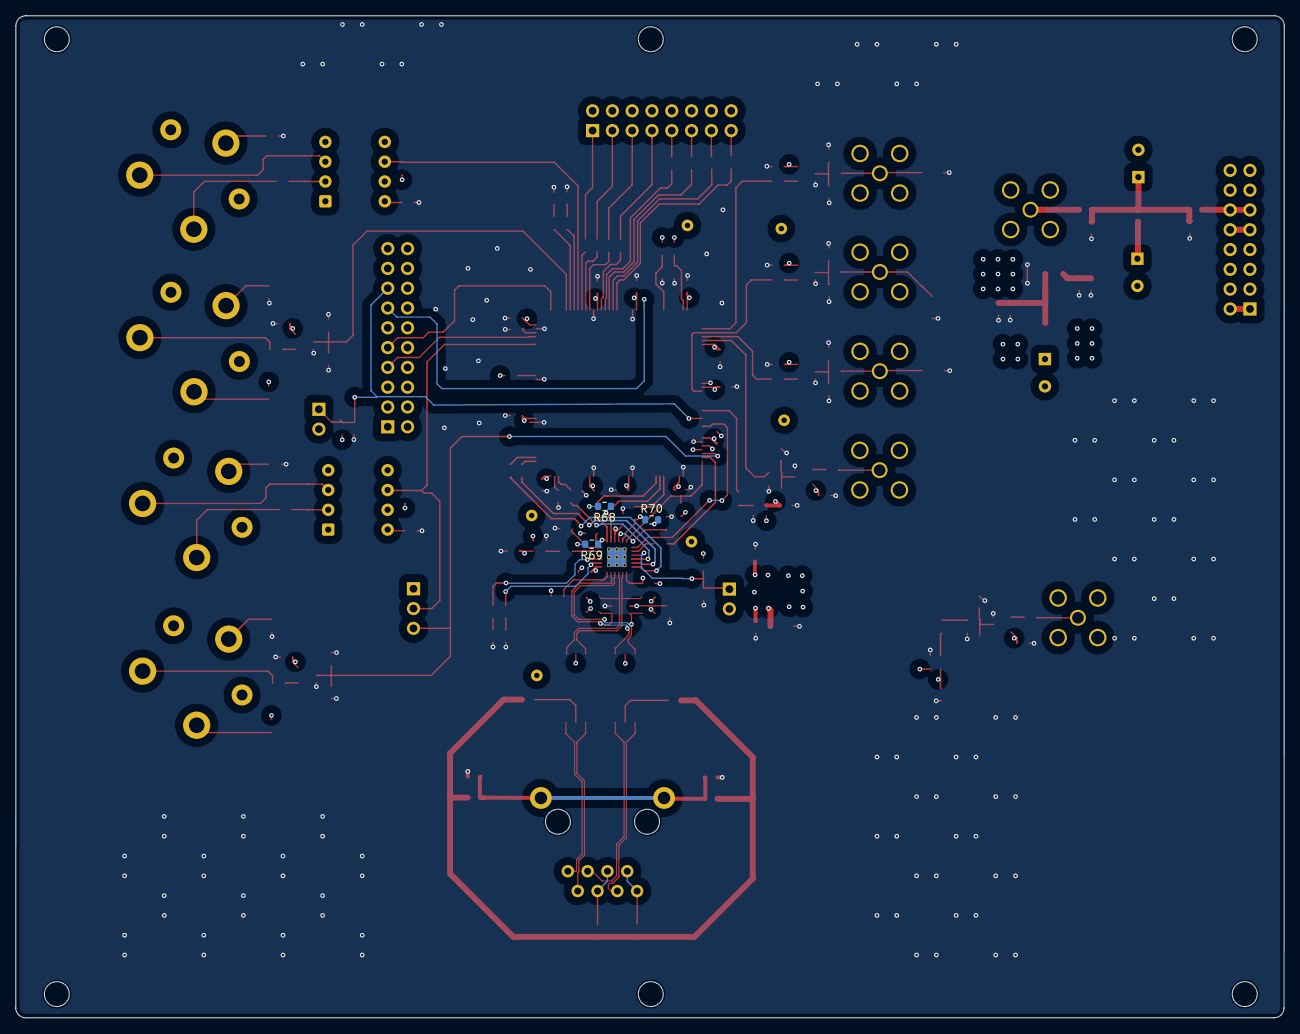
[picture p10: board tdm2ethernet1.kicad_pcb from below]

Board: 4 copper layers, 162.7 x 128.5 mm, 188 parts (3 on the bottom side), 121 nets.
