alowell-ssl/ethernet_audio/kicad/natsys_conn1/natsys_conn1.kicad_pcb

## KiCad design kicad/natsys_conn1/natsys_conn1.kicad_pcb (2025-10-06)

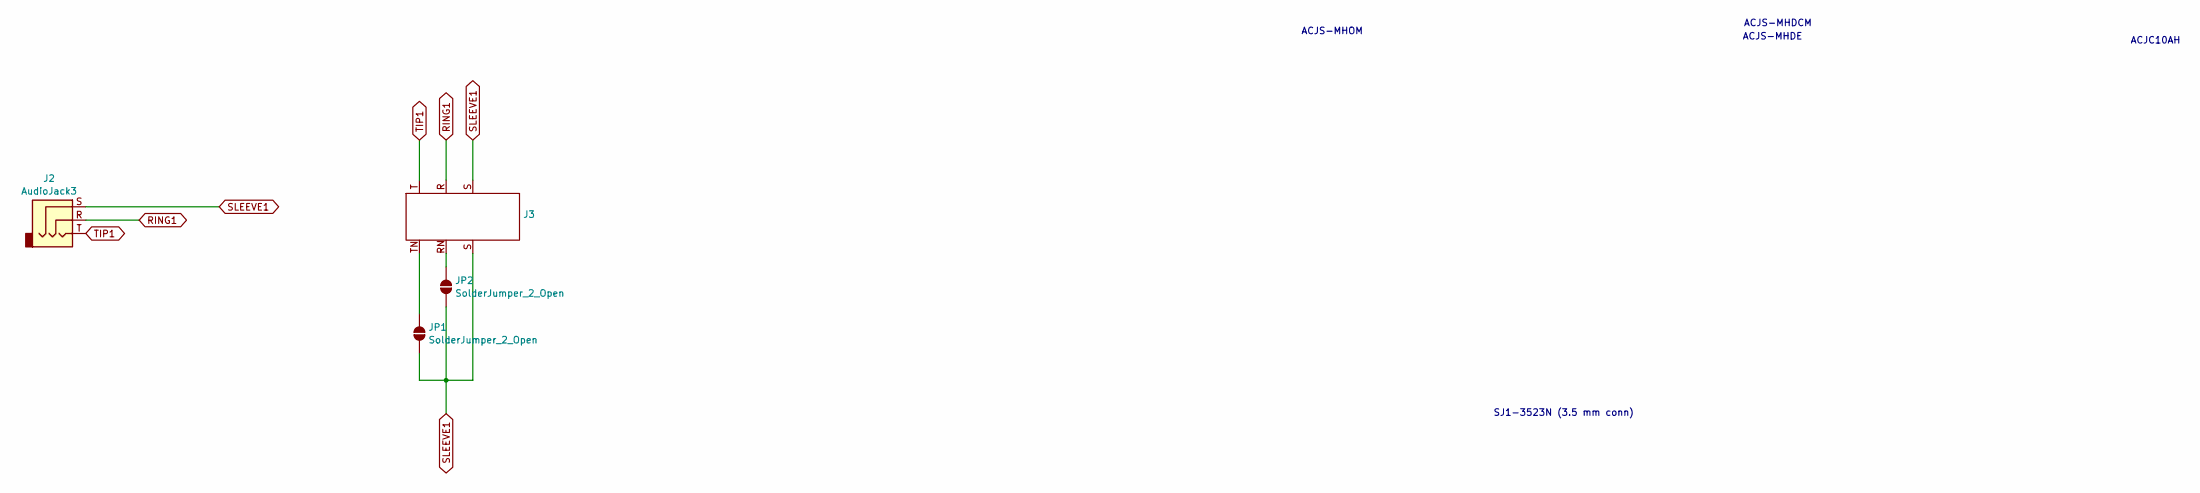
[picture p11: schematic natsys_conn1.kicad_sch]

Parts:
J2: AudioJack3; SJ1-3523N
J3: ACJS-MHOM
JP1, JP2: SolderJumper_2_Open; SolderJumper-2_P1.3mm_Open_RoundedPad1.0x1.5mm

Connections:
unnamed: J3.RN, JP2.2 (B)
unnamed: J3.TN, JP1.2 (B)
RING1: J2.R, J3.R
SLEEVE1: J2.S, J3.S, JP1.1 (A), JP2.1 (A)
TIP1: J2.T, J3.T

Notes on the sheet:
SJ1-3523N (3.5 mm conn)
ACJC10AH
ACJS-MHDE
ACJS-MHOM
ACJS-MHDCM

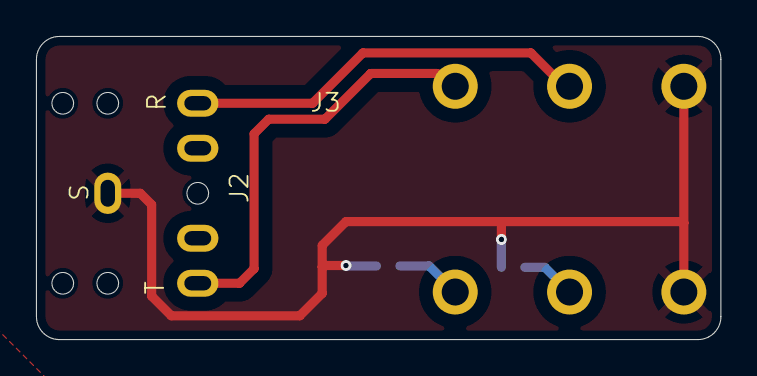
[picture p12: board natsys_conn1.kicad_pcb from above]

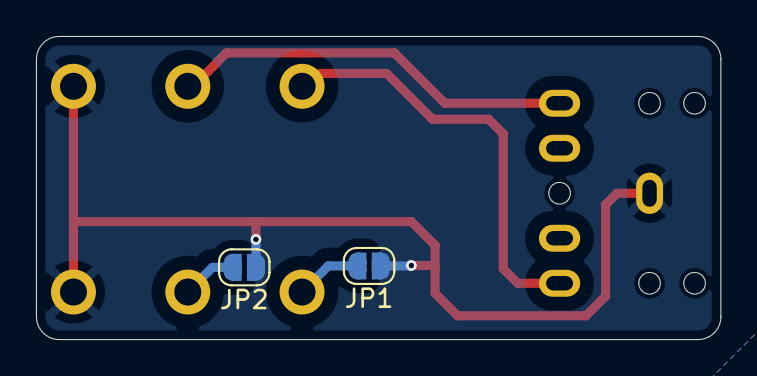
[picture p13: board natsys_conn1.kicad_pcb from below]

Board: 2 copper layers, 38.0 x 16.8 mm, 4 parts (2 on the bottom side), 5 nets.
