alowell-ssl/ethernet_audio/kicad/tdm_b1/tdm_b1.kicad_pcb

## KiCad design kicad/tdm_b1/tdm_b1.kicad_pcb (2025-10-06)

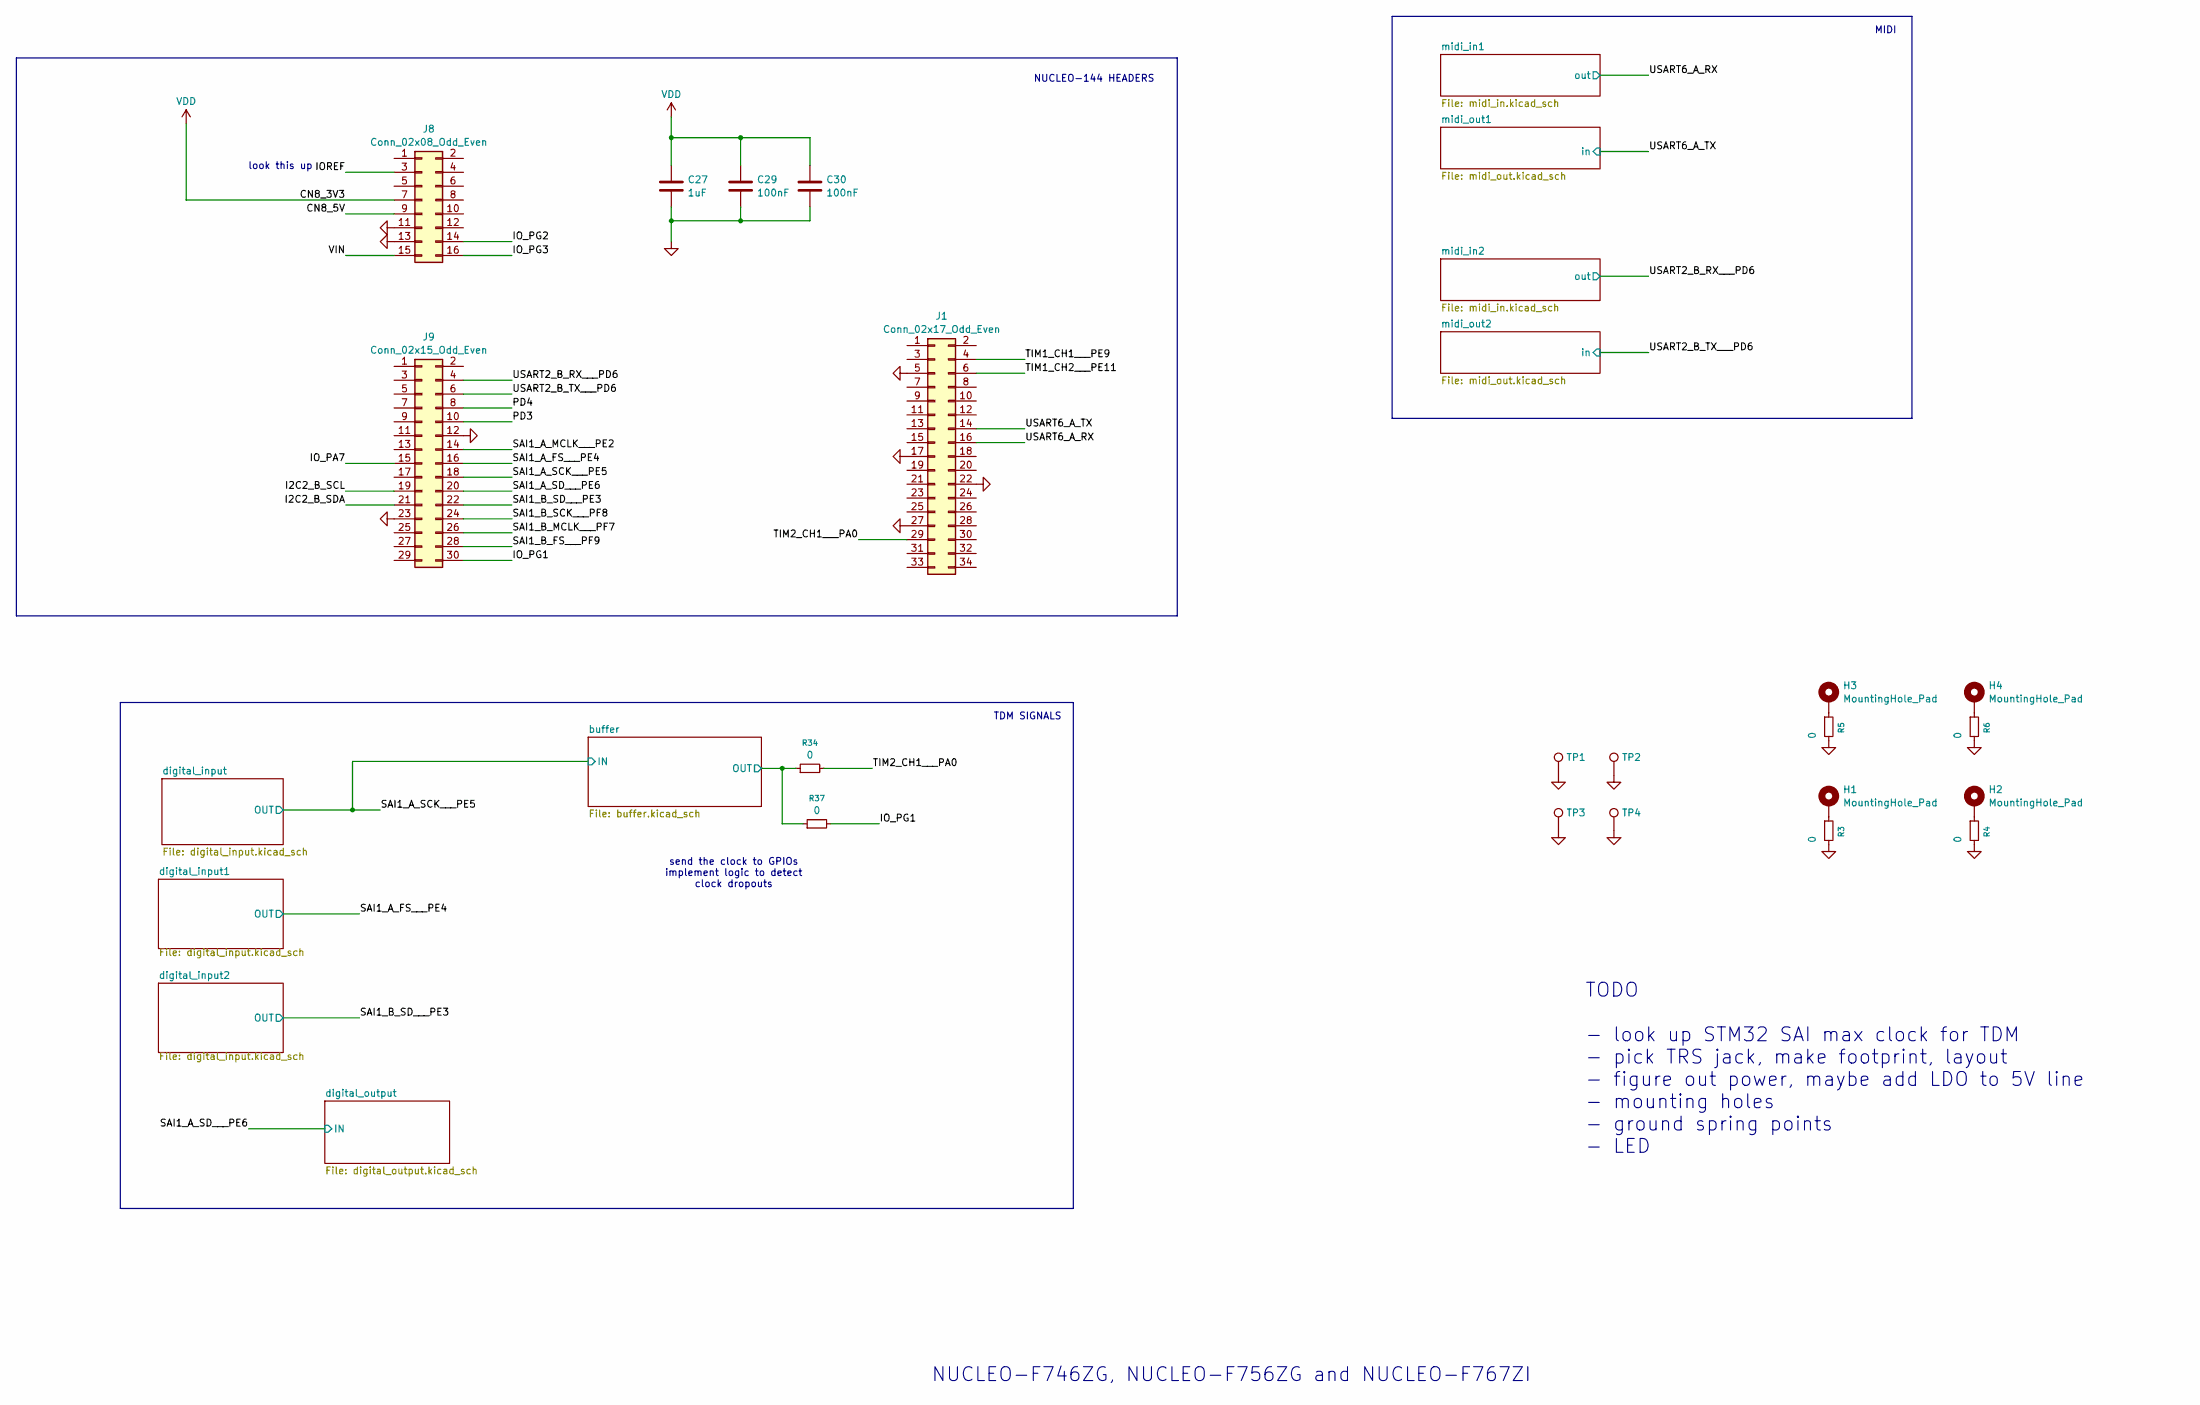
[picture p14: schematic tdm_b1.kicad_sch]

Parts:
C27: 1uF; C_0603_1608Metric
C29, C30: 100nF; C_0603_1608Metric
H1, H2, H3, H4: MountingHole_Pad; MountingHole_3.2mm_M3_DIN965_Pad
J1: Conn_02x17_Odd_Even; PinHeader_2x17_P2.54mm_Vertical
J8: Conn_02x08_Odd_Even; PinHeader_2x08_P2.54mm_Vertical
J9: Conn_02x15_Odd_Even; PinHeader_2x15_P2.54mm_Vertical
R3, R4, R5, R6, R34, R37: 0; R_0603_1608Metric
TP1, TP2, TP3, TP4: TestPoint; TestPoint_THTPad_D1.5mm_Drill0.7mm

Connections:
/CN8_5V: J8.9
/I2C2_B_SCL: J9.19
/I2C2_B_SDA: J9.21
/IOREF: J8.3
/IO_PA7: J9.15
/IO_PG1: J9.30, R37.2
/IO_PG2: J8.14
/IO_PG3: J8.16
/PD3: J9.10
/PD4: J9.8
/SAI1_A_FS___PE4: J9.16; also elsewhere on the board
/SAI1_A_MCLK___PE2: J9.14
/SAI1_A_SCK___PE5: J9.18; also elsewhere on the board
/SAI1_A_SD___PE6: J9.20; also elsewhere on the board
/SAI1_B_FS___PF9: J9.28
/SAI1_B_MCLK___PF7: J9.26
/SAI1_B_SCK___PF8: J9.24
/SAI1_B_SD___PE3: J9.22; also elsewhere on the board
/TIM1_CH1___PE9: J1.4
/TIM1_CH2___PE11: J1.6
/TIM2_CH1___PA0: J1.29, R34.2
/USART2_B_RX___PD6: J9.4; also elsewhere on the board
/USART2_B_TX___PD6: J9.6; also elsewhere on the board
/USART6_A_RX: J1.16; also elsewhere on the board
/USART6_A_TX: J1.14; also elsewhere on the board
/VIN: J8.15
/buffer/OUT: R34.1, R37.1; also elsewhere on the board
GND: C27.2, C29.2, C30.2, J1.5, J1.17, J1.22, J1.27, J8.11, J8.13, J9.12, J9.23, R3.2, R4.2, R5.2, R6.2, TP1.1, TP2.1, TP3.1, TP4.1; also elsewhere on the board
unnamed: H1.1, R3.1
unnamed: H2.1, R4.1
unnamed: H3.1, R5.1
unnamed: H4.1, R6.1
VDD: C27.1, C29.1, C30.1, J8.7; also elsewhere on the board

Notes on the sheet:
TDM SIGNALS
TODO - look up STM32 SAI max clock for TDM - pick TRS jack, make footprint, layout - figure out power, maybe add LDO to 5V line - mounting holes - ground spring points - LED
NUCLEO-144 HEADERS
look this up
send the clock to GPIOs implement logic to detect clock dropouts
NUCLEO-F746ZG, NUCLEO-F756ZG and NUCLEO-F767ZI
MIDI

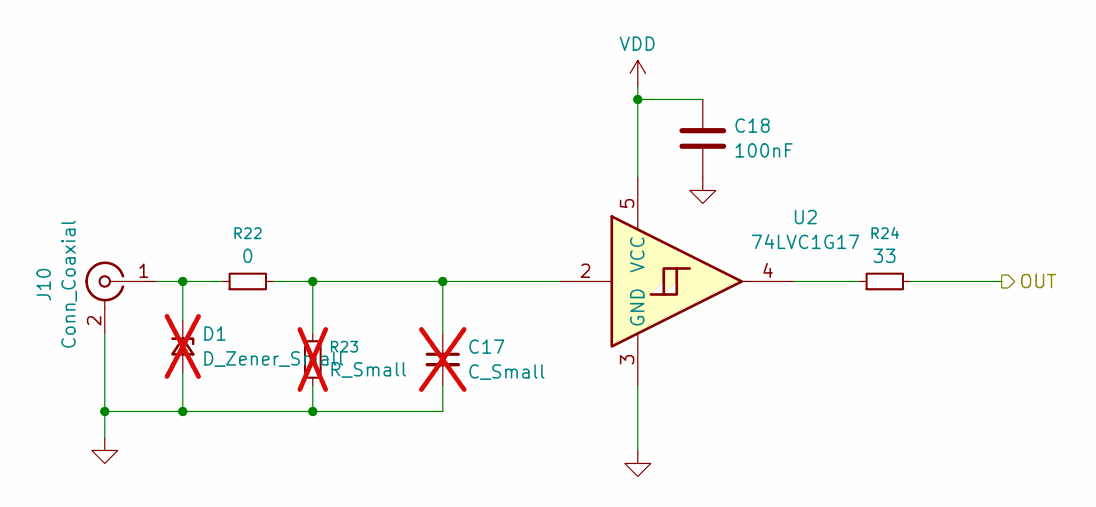
[picture p15: schematic digital_input.kicad_sch]

Parts:
C17: C_Small; C_0603_1608Metric; not fitted
C18: 100nF; C_0603_1608Metric
D1: D_Zener_Small; D_SOD-123F; not fitted
J10: Conn_Coaxial; SMA_Amphenol_901-144_Vertical
R22: 0; R_0603_1608Metric
R23: R_Small; R_0603_1608Metric; not fitted
R24: 33; R_0603_1608Metric
U2: 74LVC1G17; SOT-23-5

Connections:
/SAI1_A_SCK___PE5: R24.2; also elsewhere on the board
GND: C17.2, C18.2, D1.2 (A), J10.2 (Ext), R23.1, U2.3 (GND); also elsewhere on the board
unnamed: C17.1, R22.2, R23.2, U2.2
unnamed: D1.1 (K), J10.1 (In), R22.1
unnamed: R24.1, U2.4
VDD: C18.1, U2.5 (VCC); also elsewhere on the board

Parts of its further copies:
C19, C21: C_Small; C_0603_1608Metric; not fitted
C20, C22: 100nF; C_0603_1608Metric
D2, D3: D_Zener_Small; D_SOD-123F; not fitted
J11, J13: Conn_Coaxial; SMA_Amphenol_901-144_Vertical
R25, R28: 0; R_0603_1608Metric
R26, R29: R_Small; R_0603_1608Metric; not fitted
R27, R30: 33; R_0603_1608Metric
U3, U4: 74LVC1G17; SOT-23-5

Connections of its further copies:
/SAI1_A_FS___PE4: R27.2; also elsewhere on the board
/SAI1_B_SD___PE3: R30.2; also elsewhere on the board
GND: C19.2, C20.2, C21.2, C22.2, D2.2 (A), D3.2 (A), J11.2 (Ext), J13.2 (Ext), R26.1, R29.1, U3.3 (GND), U4.3 (GND); also elsewhere on the board
unnamed: C19.1, R25.2, R26.2, U3.2
unnamed: C21.1, R28.2, R29.2, U4.2
unnamed: D2.1 (K), J11.1 (In), R25.1
unnamed: D3.1 (K), J13.1 (In), R28.1
unnamed: R27.1, U3.4
unnamed: R30.1, U4.4
VDD: C20.1, C22.1, U3.5 (VCC), U4.5 (VCC); also elsewhere on the board

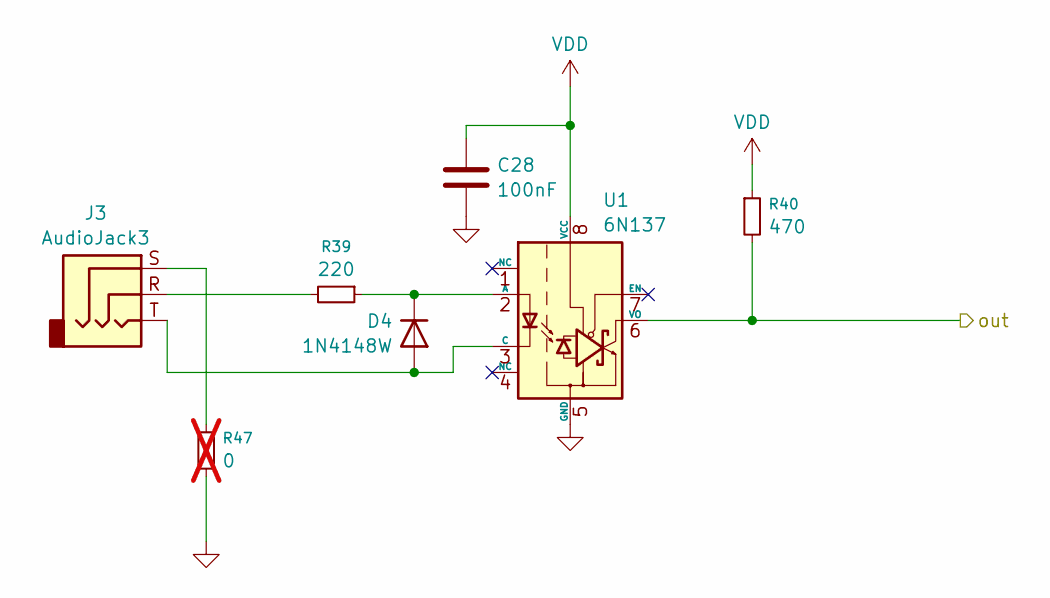
[picture p16: schematic midi_in.kicad_sch]

Parts:
C28: 100nF; C_0603_1608Metric
D4: 1N4148W; D_SOD-123
J3: AudioJack3; SJ1-3523N
R39: 220; R_0603_1608Metric
R40: 470; R_0603_1608Metric
R47: 0; R_0603_1608Metric; not fitted
U1: 6N137; DIP-8_W7.62mm

Connections:
/USART6_A_RX: R40.2, U1.6 (VO); also elsewhere on the board
GND: C28.2, R47.1, U1.5 (GND); also elsewhere on the board
unnamed: D4.2 (A), J3.T, U1.3 (C)
unnamed: D4.1 (K), R39.1, U1.2 (A)
unnamed: J3.R, R39.2
unnamed: J3.S, R47.2
VDD: C28.1, R40.1, U1.8 (VCC); also elsewhere on the board

Parts of its further copies:
C33: 100nF; C_0603_1608Metric
D5: 1N4148W; D_SOD-123
J5: AudioJack3; SJ1-3523N
R44: 220; R_0603_1608Metric
R45: 470; R_0603_1608Metric
R50: 0; R_0603_1608Metric; not fitted
U8: 6N137; DIP-8_W7.62mm

Connections of its further copies:
/USART2_B_RX___PD6: R45.2, U8.6 (VO); also elsewhere on the board
GND: C33.2, R50.1, U8.5 (GND); also elsewhere on the board
unnamed: D5.2 (A), J5.T, U8.3 (C)
unnamed: D5.1 (K), R44.1, U8.2 (A)
unnamed: J5.R, R44.2
unnamed: J5.S, R50.2
VDD: C33.1, R45.1, U8.8 (VCC); also elsewhere on the board

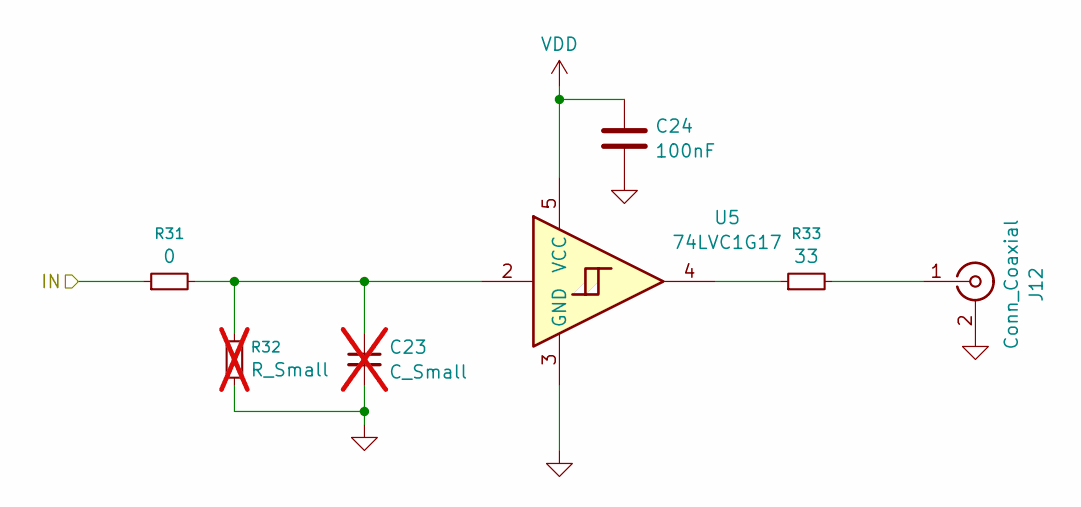
[picture p17: schematic digital_output.kicad_sch]

Parts:
C23: C_Small; C_0603_1608Metric; not fitted
C24: 100nF; C_0603_1608Metric
J12: Conn_Coaxial; SMA_Amphenol_901-144_Vertical
R31: 0; R_0603_1608Metric
R32: R_Small; R_0603_1608Metric; not fitted
R33: 33; R_0603_1608Metric
U5: 74LVC1G17; SOT-23-5

Connections:
/SAI1_A_SD___PE6: R31.1; also elsewhere on the board
GND: C23.2, C24.2, J12.2 (Ext), R32.1, U5.3 (GND); also elsewhere on the board
unnamed: C23.1, R31.2, R32.2, U5.2
unnamed: J12.1 (In), R33.2
unnamed: R33.1, U5.4
VDD: C24.1, U5.5 (VCC); also elsewhere on the board

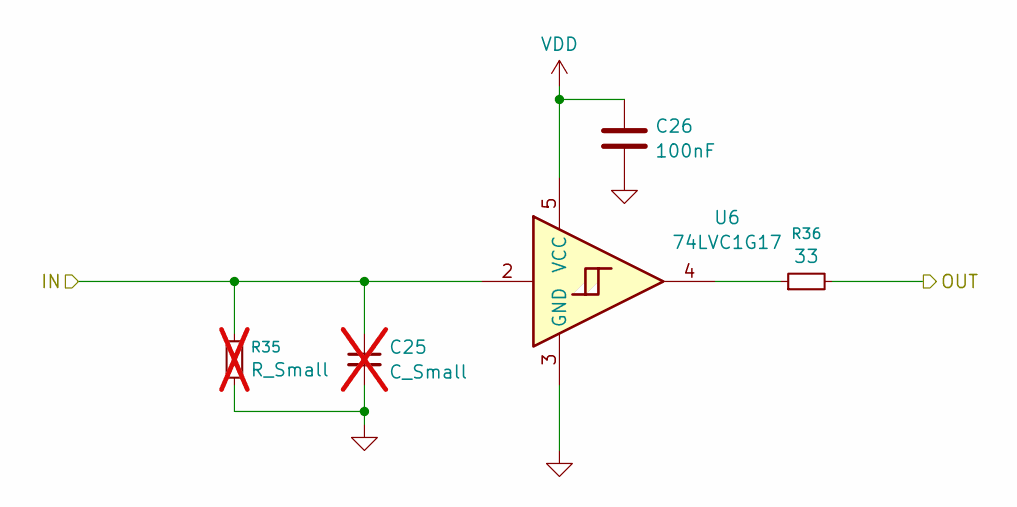
[picture p18: schematic buffer.kicad_sch]

Parts:
C25: C_Small; C_0603_1608Metric; not fitted
C26: 100nF; C_0603_1608Metric
R35: R_Small; R_0603_1608Metric; not fitted
R36: 33; R_0603_1608Metric
U6: 74LVC1G17; SOT-23-5

Connections:
/SAI1_A_SCK___PE5: C25.1, R35.2, U6.2; also elsewhere on the board
/buffer/OUT: R36.2; also elsewhere on the board
GND: C25.2, C26.2, R35.1, U6.3 (GND); also elsewhere on the board
unnamed: R36.1, U6.4
VDD: C26.1, U6.5 (VCC); also elsewhere on the board

Parts of its further copies:
C31, C34: C_Small; C_0603_1608Metric; not fitted
C32, C35: 100nF; C_0603_1608Metric
R41, R46: R_Small; R_0603_1608Metric; not fitted
R42, R51: 33; R_0603_1608Metric
U7, U9: 74LVC1G17; SOT-23-5

Connections of its further copies:
/USART2_B_TX___PD6: C34.1, R46.2, U9.2; also elsewhere on the board
/USART6_A_TX: C31.1, R41.2, U7.2; also elsewhere on the board
/midi_out1/MIDI_OUT: R42.2; also elsewhere on the board
/midi_out2/MIDI_OUT: R51.2; also elsewhere on the board
GND: C31.2, C32.2, C34.2, C35.2, R41.1, R46.1, U7.3 (GND), U9.3 (GND); also elsewhere on the board
unnamed: R42.1, U7.4
unnamed: R51.1, U9.4
VDD: C32.1, C35.1, U7.5 (VCC), U9.5 (VCC); also elsewhere on the board

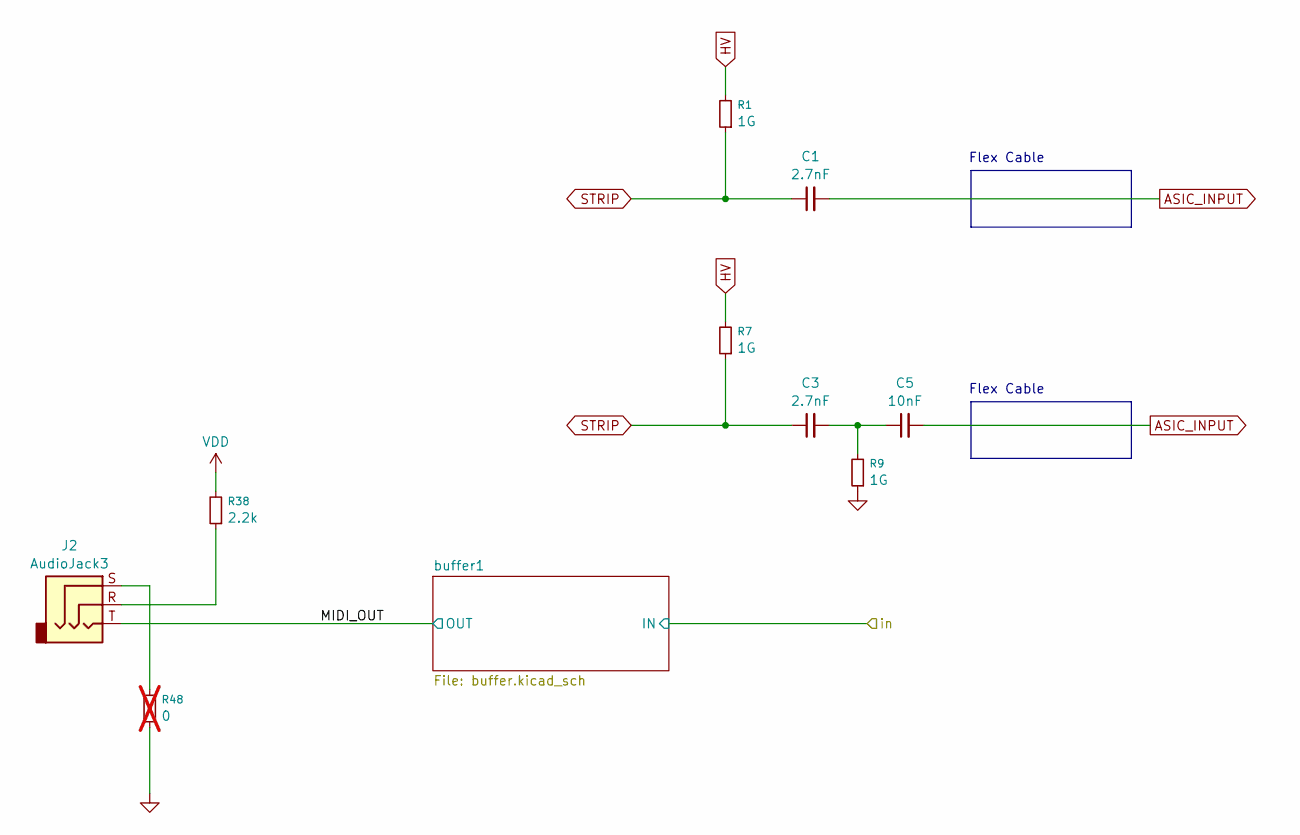
[picture p19: schematic midi_out.kicad_sch]

Parts:
C1, C3: 2.7nF
C5: 10nF
J2: AudioJack3; SJ1-3523N
R1, R7, R9: 1G; R_0603_1608Metric
R38: 2.2k; R_0603_1608Metric
R48: 0; R_0603_1608Metric; not fitted

Connections:
/midi_out1/MIDI_OUT: J2.T; also elsewhere on the board
GND: R9.1, R48.1; also elsewhere on the board
unnamed: C1.1, C3.1, R1.1, R7.1
unnamed: C1.2, C5.2
unnamed: C3.2, C5.1, R9.2
unnamed: J2.R, R38.1
unnamed: J2.S, R48.2
unnamed: R1.2, R7.2
VDD: R38.2; also elsewhere on the board

Parts of its further copies:
J4: AudioJack3; SJ1-3523N
R43: 2.2k; R_0603_1608Metric
R49: 0; R_0603_1608Metric; not fitted

Connections of its further copies:
/midi_out2/MIDI_OUT: J4.T; also elsewhere on the board
GND: R49.1; also elsewhere on the board
unnamed: J4.R, R43.1
unnamed: J4.S, R49.2
VDD: R43.2; also elsewhere on the board

Notes on the sheet:
Flex Cable

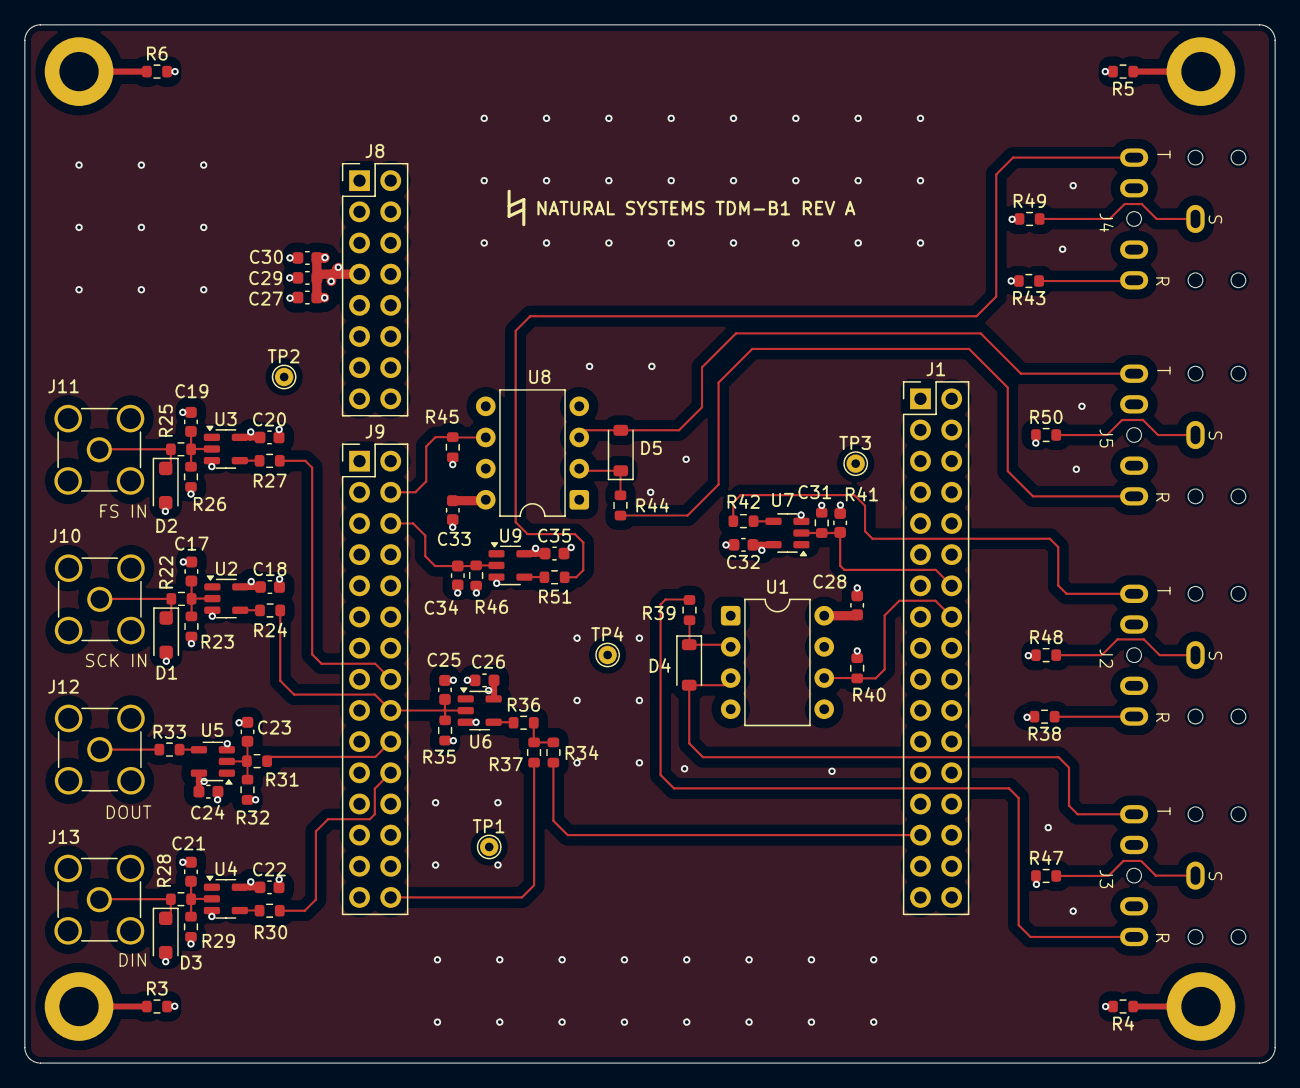
[picture p20: board tdm_b1.kicad_pcb from above]

Board: 4 copper layers, 101.9 x 84.6 mm, 86 parts (0 on the bottom side), 46 nets.
